nk-kotsomitis/Senseed/README.md

## Introduction

Senseed, a Smart Agriculture IoT System, is an end-to-end IoT solution designed to monitor and manage agricultural environments. This repository includes the **firmware**, **hardware**, **enclosures**, and **server setup** required to deploy the system.<br>
<br>
<br>
<div align="center">
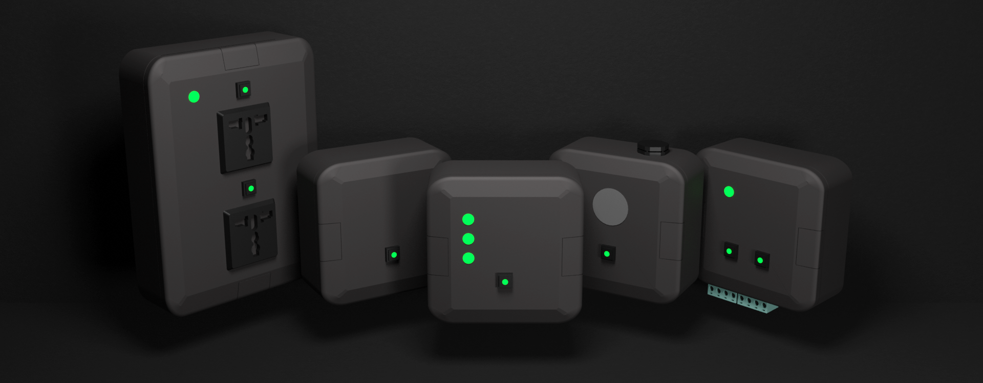
[picture p1: assets/img.png]
senseed
  
</div>
<br>
<br>

## System Overview
This system leverages a wireless sensor network in a star topology, using **NRF24L01** modules operating at 2.4GHz for communication. The network comprises soil and environmental sensors that gather data and transmit it to a central gateway. The gateway serves as the primary hub, collecting sensor data and communicating with the controllers to make real-time adjustments. <br>
<br>
For data processing and storage, the gateway connects to an Ubuntu server over **WiFi**, using the **MQTT** protocol with **RabbitMQ** as the message broker. On the server side, **InfluxDB** is used for time-series data storage. <br>

<br>
<br>
<div align="center">
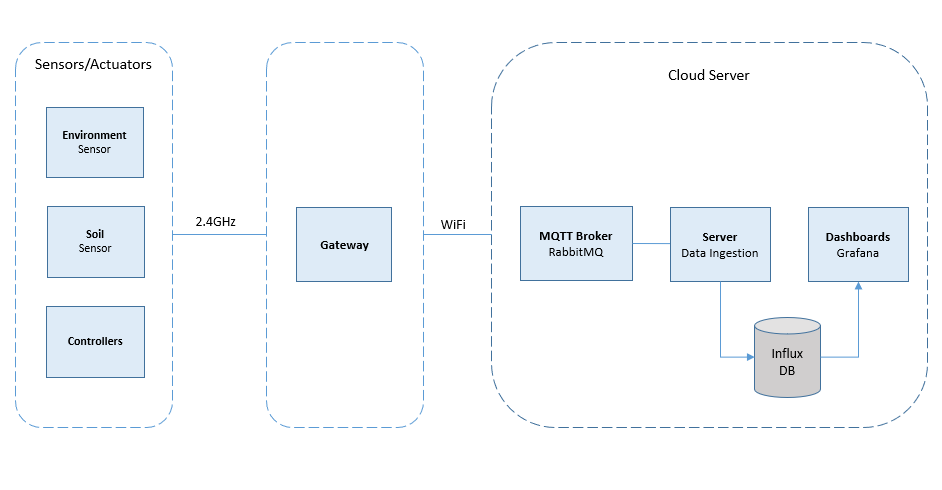
[picture p2: assets/img2.png]
overview
  
</div>
<br>
<br>

The gateway is powered by an **ATMEGA1284** and connects to the internet via an **ESP32** module, utilizing AT commands. The sensors and controllers in the system are based on the **ATMEGA328P** microcontroller. <br>
<br>
The environmental sensor is optimized for low-power operation, measuring temperature and humidity with a high-precision SHT40 sensor while also monitoring battery voltage to ensure reliable performance over extended periods. <br>
<br>
The soil sensor assesses soil moisture levels using a moisture probe. <br>
<br>
The controllers are designed for both low and high-power applications, managing devices through relay control. Each controller is equipped with a battery-powered real-time clock (RTC) to maintain accurate time in case of power outages. The high-power controller additionally monitors current consumption using an ACS712 sensor for enhanced energy management.

<br>
<br>

**IMPORTANT NOTE: This repository contains a proof-of-concept implementation and is intended for demonstration purposes to showcase architecture design and coding practices. Some components are intentionally missing or incomplete, so the system is not production-ready.**
