nk-kotsomitis/Senseed/hardware/controllers/BOM_controller_low_power_v1.0.1.xlsx

# | Reference Designators | Quantity | MPN | Manufacturer | Part Description | Value | Package | Remark or Link
1 | U1 | 1 | ATMEGA328P-AU | Microchip Technology / Atmel | 8-bit Microcontrollers - MCU 32KB In-system Flash 20MHz 1.8V-5.5V | ATMEGA328P_TQFP | TQFP-32
2 | U3 | 1 | SPX1117M3-L-3-3/TR | Maxlinear | LDO Voltage Regulators 3.3V 0.8A Positive | 3.3 V | SOT-223-3
3 | U5 | 1 | - | - | NRF24L01+ 2.4GHz Wireless RF Transceiver Module | - | Plug In Module - 2x4 2.54mm header | Customer Provided
4 | U6 | 1 | MCP79410T-I/SN | Microchip Technology | Real Time Clock I2C GP RTCC 1Kb EE 64B SRAM ID | - | SOIC-8
5 | BH1 | 1 | MY-1220-03 | MYOUNG | Coin Cell Battery Holder CR1220 SMT | - | SMD
6 | K1, K2 | 2 | G2RL-1A-E-ASI DC5 | Omron Electronics | General Purpose Relays 1 form A w/ TV3 5VDC Coil, 16A | Power Relays | Through Hole
7 | Y1 | 1 | TAXM4M2ILFBET2T | TAE(Zhejiang Abel Elec) | ±30ppm -20℃~70℃ 49SMD 20pF 80Ω 4000000Hz HC-49S/SMD Crystals | 4 MHz | HC-49/S
8 | Y2 | 1 | JFWSH32K25A104C | SHENZHEN JINGFA ELECTRONICS | Radial Cylinder Crystal 32.768KHz ±20ppm 12.5pF 30 KOhm(Max) Radial,3x8mm | 32.768 kHz | OSC-TH Radial 3x8mm
9 | J2, J3 | 2 | PH2.0-4P | CAX | 4-Pin Low-profile PH2.0 Housing Connector | 4 Position | Through Hole
10 | LED | 1 | 204-10SUGC/S400-A5-L | Everlight Elec | Green 525nm Through Hole 3mm Light Emitting Diodes (LED) - Water Clear | 3mm Green - Clear | Through Hole
11 | LED | 1 | ERM 1-955 | Bivar | LED Mounting Hardware LED Mount Self Ret Universal LED Black | T-1 3/4 (5mm) | -
12 | J5 | 1 | C65114 | BOOMELE(Boom Precision Elec) | 2 2.54mm 6 Straight Header，Breakaway P=2.54mm Pin Headers | 6 Position | Through Hole
13 | J6 | 1 | PZ254V-11-02P | XFCN | 2.54mm Straight 2 1 Header，Breakaway Through Hole,P=2.54mm Pin Headers | 2 Position | Through Hole
14 | J7, J8 | 2 | WJ2EDGRC-5.08-4P | Ningbo Kangnex Elec | Pluggable Terminal Blocks 4Pins Pitch 5.08 Right Angle | 4 Position | Through Hole
15 | Q1, Q2 | 2 | MMBT2222A |  | (BJT) NPN 600mA 40V SURFACE MOUNT TRANSISTOR | NPN | SOT23-3
16 | D1, D2 | 2 | 1N4007F (M7) |  | Silicon Rectifier Diode 1A 1000V SMA | 50 V | SMA / DO-214AC
17 | C1, C2, C14, C15 | 4 | 0805CG150J500NT |  | Multilayer Ceramic Capacitor MLCC 15pF ±5% 0805 SMD | 15pF | 0805
18 | C3, C4, C5, C16 | 4 | 0805B104M500NT |  | Multilayer Ceramic Capacitor MLCC 100nF ±5% 0805 SMD | 100nF | 0805
19 | C11 | 1 | CL21B225KOFNNNE |  | Multilayer Ceramic Capacitor MLCC 2.2uF X7R ±10% 16V 0805 SMD | 2.2uF | 0805
20 | C10 | 1 | CL21A475KAQNNNE |  | Multilayer Ceramic Capacitor MLCC 4.7uF X5R ±10% 25V 0805 SMD | 4.7uF | 0805
21 | C12 | 1 | GRM21BR61C106KE15L |  | X5R ±10% 16V 10uF 0805 Multilayer Ceramic Capacitors MLCC - SMD/SMT | 10uF | 0805
22 | C13 | 1 | VD1A331ME077000CE0 | Changzhou Huawei Electronics | 6.3mm 330uF 7.7mm 10V 2000hrs 105℃ ±20% -45℃~+105℃ SMD,6.3x7.7mm Aluminum Electrolytic Capacitors - SMD | 330uF | 6.3x7.7 SMD
23 | R1, R3, R5, R9 | 4 | RC0805FR-7W10KL |  | Chip Resistor - Surface Mount 10K ±1% 1/4W 0805 | 10K 1/4W | 0805
24 | R2, R4, R11, R12 | 4 | 0805W8J1001T5E |  | Chip Resistor - Surface Mount 1K ±5% 1/8W 0805 | 1K | 0805
25 | R6, R7, R8, R10 | 4 | 0805W8J0472T5E |  | Chip Resistor - Surface Mount 4.7K ±5% 1/8W 0805 | 4K7 | 0805
 | Off-board components
26 | - | 1 | CMC_313_GTP | Visual Communications Company (VCC) | LED Lenses Green Diffused 5mm CMC313GTP | Green | -
27 | - | 2 | TC013-N11ASKKUGXX | Well Buying | Tactile Switches TACTILE/JOG SWITCH SPST50mA 12VDC180gf | Illuminated | -
28 | - | 2 | - |  | PH2.0 PH 2.0 4pin PH-4p connector with cable 100mm wire 24AWG | PH-4p 100mm 24AWG | -
29 |  | 2 | WJ2EDGK-5.08-4P | Ningbo Kangnex Elec | Pluggable Terminal Blocks Screw Connector 4Pins Pitch 5.08 | 4 Position | -
