nk-kotsomitis/Senseed/hardware/environment_sensor/BOM_env_sensor_v1.0.1.xlsx

# | Reference Designators | Quantity | MPN | Manufacturer | Part Description | Value | Package | Remark or Link
1 | U1 | 1 | ATMEGA328P-AU | Microchip Technology / Atmel | 8-bit Microcontrollers - MCU 32KB In-system Flash 20MHz 1.8V-5.5V | - | TQFP-32
2 | U2 | 1 | - | NRF24L01+ 2.4GHz Wireless RF Transceiver Module | - | Plug In Module - 2x4 2.54mm header | Customer Provided
3 | U3 | 1 | SHT40-AD1B-R2 | Sensirion | Board Mount Humidity Sensors RH/ T Sensor | SHT40-AD1B-R2 | DFN-4
4 | U4 | 1 | USEQGSEAC82180 | KEMET | Air Quality Sensors Gas Detector Sensor Digital SMD CO2 | Carbon Dioxide (CO2) | SMD/SMT
5 | U5 | 1 | TCA9406DCTR | Texas Instruments | Translation - Voltage Levels Dual Bidirec 1MHz Vltg Lev-Trans | Translation - Voltage Levels | SM-8
6 | U6 | 1 | TPS60205DGSR | Texas Instruments | Switching Voltage Regulators Regulated 3.3-V Charge Pump | 3.3 V | MSOP-10
7 | Y1 | 1 | TAXM4M2ILFBET2T | TAE(Zhejiang Abel Elec) | ±30ppm -20℃~70℃ 49SMD 20pF 80Ω 4000000Hz HC-49S/SMD Crystals | 4 MHz | HC-49/S
8 | Q1, Q2 | 2 | SSM3J328R,LF | Toshiba | MOSFET P-Ch Sm Sig FET Id -6A -20V -8VGSS | P-channel | SOT-23F-3
9 | D1 | 1 | SBAT54CLT1G | ON Semiconductor | Schottky Diodes & Rectifiers SS DUAL COMMON CATHODE | Si | SOT-23
11 | J1 | 1 | PH2.0-4P | CAX | 4-Pin Low-profile PH2.0 Housing Connector | 4 Position | Through Hole
12 | J2 | 1 | C65114 | BOOMELE(Boom Precision Elec) | 2 2.54mm 6 Straight Header，Breakaway P=2.54mm Pin Headers | 6 Position | Through Hole
13 | J3 | 1 | PZ254V-11-02P | XFCN | 2.54mm Straight 2 1 Header，Breakaway Through Hole,P=2.54mm Pin Headers | 2 Position | Through Hole
14 | J4 | 1 | 2462 | Keystone Electronics | Cylindrical Battery Contacts, Clips, Holders & Springs 2 CELL AA PC HOLDER | AA 2 Battery | Through Hole
15 | J5 | 1 | ZW-02-20-F-D-800-079 | Samtec | Board to Board & Mezzanine Connectors .100" Flex Stack, Flexible Board Stacker, Custom Tail | 4 Position | Through Hole
16 | CBAT | 1 | VD1A331ME077000CE0 | Changzhou Huawei Electronics | 6.3mm 330uF 7.7mm 10V 2000hrs 105℃ ±20% -45℃~+105℃ SMD,6.3x7.7mm Aluminum Electrolytic Capacitors - SMD | 330uF | 6.3x7.7 SMD
18 | C1, C2 | 2 | 0805CG150J500NT |  | Multilayer Ceramic Capacitor MLCC 15pF ±5% 0805 SMD | 15pF | 0805
19 | C9 | 1 | TCC0805X7R224K500DT |  | 50V 220nF X7R ±10% 0805 Multilayer Ceramic Capacitors MLCC - SMD/SMT | 220nF | 0805
20 | C3, C4, C5, C6, C8, C14, C15, C17 | 8 | 0805B104M500NT |  | Multilayer Ceramic Capacitor MLCC 100nF ±5% 0805 SMD | 100nF | 0805
21 | C11, C12 | 2 | CL21B105KOFNNNE |  | Multilayer Ceramic Capacitor MLCC 1uF X7R ±10% 16V 0805 SMD | 1uF | 0805
22 | C10, C13 | 2 | CL21B225KOFNNNE |  | Multilayer Ceramic Capacitor MLCC 2.2uF X7R ±10% 16V 0805 SMD | 2.2uF | 0805
23 | C7 | 1 | GRM21BR61C106KE15L |  | X5R ±10% 16V 10uF 0805 Multilayer Ceramic Capacitors MLCC - SMD/SMT | 10uF | 0805
24 | C16 | 1 | CL21A475KAQNNNE |  | 25V 4.7uF X5R ±10% 0805 Multilayer Ceramic Capacitors MLCC - SMD/SMT | 4.7uF | 0805
25 | R1, R6, R7, R8, R9 | 5 | RC0805FR-7W10KL |  | Chip Resistor - Surface Mount 10K ±1% 1/4W 0805 | 10K 1/4W | 0805
26 | R2 | 1 | 0805W8J0105T5E |  | Chip Resistor - Surface Mount 1M ±5% 1/8W 0805 | 1M | 0805
27 | R3 | 1 | 0805W8J0474T5E |  | Chip Resistor - Surface Mount 470K ±5% 1/8W 0805 | 470K | 0805
28 | R4, R5 | 2 | 0805W8J1001T5E |  | Chip Resistor - Surface Mount 1K ±5% 1/8W 0805 | 1K | 0805
 | Off-board components
29 | - | 1 | TC013-N11ASKKUGXX | Well Buying | Tactile Switches TACTILE/JOG SWITCH SPST50mA 12VDC180gf | Illuminated | -
30 | - | 1 | - | - | PH2.0 PH 2.0 4pin PH-4p connector with cable 100mm wire 24AWG | PH-4p 100mm 24AWG | -
