nk-kotsomitis/Senseed/hardware/environment_sensor/BOM_spectrometer_v1.0.1.xlsx

# | Reference Designators | Quantity | MPN | Manufacturer | Part Description | Value | Package
1 | U1 | 1 | AS72651-BLGT | ams | Ambient Light Sensors AS72651-BLGT LGA20 LF T&RDP | 600 nm to 870 nm | LGA-20
2 | U2 | 1 | AS72652-BLGT | ams | Ambient Light Sensors AS72652-BLGT LGA20 LF T&RDP | - | LGA-20
3 | U3 | 1 | AS72653-BLGT | ams | Ambient Light Sensors AS72653-BLGT LGA20 LF T&RDP | - | LGA-20
4 | U4 | 1 | AT25SF041B-SSHB-B | Adesto Technologies | NOR Flash 4 Mbit, 3.0V (2.7V to 3.6V), -40C to 85C, SOIC-N 150mil (Tube), Single, Dual, Quad SPI NOR flash | 4 Mbit | SOIC-8 Narrow
5 | J2 | 1 | PZ254V-12-10P | XFCN | 2 2.54mm 10 Straight Header，Breakaway Through Hole,P=2.54mm Pin Headers ROHS | 10 Position | Through Hole
6 | R1, R2 | 2 | 0805W8J0472T5E |  | Chip Resistor - Surface Mount 4.7K ±5% 1/8W 0805 | 4K7 | 0805
7 | R3, R4, R5, R6, R7 | 5 | RC0805FR-7W10KL |  | Chip Resistor - Surface Mount 10K ±1% 1/4W 0805 | 10K | 0805
8 | C1, C3, C5 | 3 | GRM21BR61C106KE15L |  | X5R ±10% 16V 10uF 0805 Multilayer Ceramic Capacitors MLCC - SMD/SMT | 10uF | 0805
9 | C2, C4, C6 | 3 | 0805B104M500NT |  | Multilayer Ceramic Capacitor MLCC 100nF ±5% 0805 SMD | 100nF | 0805
10 | C7 | 1 | UMK212B7105KG-T |  | X7R ±10% 50V 1uF 0805 Multilayer Ceramic Capacitors MLCC - SMD/SMT | 1uF | 0805
