nk-kotsomitis/Senseed/hardware/gateway/BOM_gateway_v1.0.1.xlsx

# | Reference Designators | Quantity | MPN | Manufacturer | Part Description | Value | Package | Remark or Link
1 | U1 | 1 | ATMEGA1284-AU | Microchip Technology / Atmel | 8-bit Microcontrollers - MCU AVR 128KB FLSH 4KB EE16KB SRAM-20 MHz | - | TQFP-44
2 | U2 | 1 | SPX1117M3-L-3-3/TR | Maxlinear | LDO Voltage Regulators 3.3V 0.8A Positive | 3.3V 0.8A | SOT-223-3
3 | U4 | 1 | - | - | NRF24L01+ 2.4GHz Wireless RF Transceiver Module | - | Plug In Module - 2x4 2.54mm header | Customer Provided
4 | U5 | 1 | ESP-WROOM-02D(M1102H1600PH3Q0) | Espressif Systems | WiFi Modules (802.11) SMD Module, ESP8266EX, 16Mbits SPI flash, UART Mode, PCB antenna | - | SMD module
5 | U6 | 1 | MCP79410T-I/SN | Microchip Technology | Real Time Clock I2C GP RTCC 1Kb EE 64B SRAM ID | - | SOIC-8
6 | BH1 | 1 | MY-1220-03 | MYOUNG | Coin Cell Battery Holder CR1220 SMT | - | SMD
7 | Y1 | 1 | TXM16M0004322KBCDO00T | TAE(Zhejiang Abel Elec) | ±10ppm 16000000Hz -40℃~85℃ 18pF SMD Passive Crystal Oscillator 35Ω SMD3225-4P Crystals | 16 MHz | SMD3225-4P
8 | Y2 | 1 | JFWSH32K25A104C | SHENZHEN JINGFA ELECTRONICS | Radial Cylinder Crystal 32.768KHz ±20ppm 12.5pF 30 KOhm(Max) Radial,3x8mm | 32.768 kHz | OSC-TH Radial 3x8mm
9 | J1 | 1 | PH2.0-4P | CAX | 4-Pin Low-profile PH2.0 Housing Connector | 4 Position | Through Hole
10 | LED1, LED2, LED3 | 3 | 204-10SUGC/S400-A5-L | Everlight Elec | Green 525nm Through Hole 3mm Light Emitting Diodes (LED) - Water Clear | 3mm Green - Clear | Through Hole
11 | LED1, LED2, LED3 | 3 | ERM 1-955 | Bivar | LED Mounting Hardware LED Mount Self Ret Universal LED Black | T-1 3/4 (5mm) | - | Led Spacer
12 | J6 | 1 | C65114 | BOOMELE(Boom Precision Elec) | 2 2.54mm 6 Straight Header，Breakaway P=2.54mm Pin Headers | 6 Position | Through Hole
13 | J7 | 1 | PZ254V-11-02P | XFCN | 2.54mm Straight 2 1 Header，Breakaway Through Hole,P=2.54mm Pin Headers | 2 Position | Through Hole
14 | J8 | 1 | C49257 | BOOMELE(Boom Precision Elec) | 3 2.54mm Straight 1 Header，Breakaway Through Hole Pin Headers | 3 Position | Through Hole
15 | S2, S3 | 2 | TS-1096S-A2B2-C1D2 | Yuandi | SPST Vertical Tactile Switch 3X6X5.0mm SMT | - | SMD
16 | C15, C16 | 2 | 0805CG150J500NT |  | Multilayer Ceramic Capacitor MLCC 15pF ±5% 0805 SMD | 15pF | 0805
17 | C1, C2 | 2 | 0805CG270J500NT |  | Multilayer Ceramic Capacitor MLCC 27pF ±5% 0805 SMD | 27pF | 0805
18 | C3, C4, C5, C6, C7, C13, C14, C17 | 8 | 0805B104M500NT |  | Multilayer Ceramic Capacitor MLCC 100nF ±5% 0805 SMD | 100nF | 0805
19 | C9 | 1 | CL21B225KOFNNNE |  | Multilayer Ceramic Capacitor MLCC 2.2uF X7R ±10% 16V 0805 SMD | 2.2uF | 0805
20 | C8 | 1 | CL21A475KAQNNNE |  | Multilayer Ceramic Capacitor MLCC 4.7uF X5R ±10% 25V 0805 SMD | 4.7uF | 0805
21 | C10, C12 | 2 | GRM21BR61C106KE15L |  | X5R ±10% 16V 10uF 0805 Multilayer Ceramic Capacitors MLCC - SMD/SMT | 10uF | 0805
22 | C11 | 1 | VD1A331ME077000CE0 | Changzhou Huawei Electronics | 6.3mm 330uF 7.7mm 10V 2000hrs 105℃ ±20% -45℃~+105℃ SMD,6.3x7.7mm Aluminum Electrolytic Capacitors - SMD | 330uF | 6.3x7.7 SMD
23 | R1, R2, R11, R12, R13, R16, R17, R18 | 8 | 0805W8J1002T5E |  | Chip Resistor - Surface Mount 10K ±5% 1/8W 0805 | 10K | 0805
24 | R14 | 1 | 0805W8J1001T5E |  | Chip Resistor - Surface Mount 1K ±5% 1/8W 0805 | 1K | 0805
25 | R15 | 1 | 0805W8J2001T5E |  | Chip Resistor - Surface Mount 2K ±5% 1/8W 0805 | 2K | 0805
26 | R4, R5, R6, R7, R8, R9, R10, R19 | 8 | 0805W8J0472T5E |  | Chip Resistor - Surface Mount 4.7K ±5% 1/8W 0805 | 4K7 | 0805
 | Off-board components
27 | - | 1 | TC013-N11ASKKUGXX | Well Buying | Tactile Switches TACTILE/JOG SWITCH SPST50mA 12VDC180gf | Illuminated | -
28 | - | 3 | CMC_313_GTP | Visual Communications Company (VCC) | LED Lenses Green Diffused 5mm CMC313GTP | Green | -
29 | - | 1 | - | - | PH2.0 PH 2.0 4pin PH-4p connector with cable 100mm wire 24AWG | PH-4p 100mm 24AWG | -
