nk-kotsomitis/Senseed/hardware/soil_sensor/BOM_sensor_v1.0.1.xlsx

# | Reference Designators | Quantity | MPN | Manufacturer | Part Description | Value | Package | Remark or Link
1 | U1 | 1 | ATMEGA328P-AU | Microchip Technology / Atmel | 8-bit Microcontrollers - MCU 32KB In-system Flash 20MHz 1.8V-5.5V | ATMEGA328P_TQFP | TQFP-32
2 | U2 | 1 | - | - | NRF24L01+ 2.4GHz Wireless RF Transceiver Module | - | Plug In Module - 2x4 2.54mm header | Customer Provided
3 | Y1 | 1 | TAXM4M2ILFBET2T | TAE(Zhejiang Abel Elec) | ±30ppm -20℃~70℃ 49SMD 20pF 80Ω 4000000Hz HC-49S/SMD Crystals | 4 MHz | HC-49/S
4 | Q1 | 1 | SSM3J328R,LF | Toshiba | MOSFET P-Ch Sm Sig FET Id -6A -20V -8VGSS |  | SOT-23F-3
5 | D1 | 1 | SBAT54CLT1G | ON Semiconductor | Schottky Diodes & Rectifiers SS DUAL COMMON CATHODE | Schottky Diodes | SOT-23
6 | D2, D3, D4, D5 | 4 | 1SS384TE85LF | 1SS384TE85LF | Schottky Diodes & Rectifiers 0.1A 10V Schottky Small Sig Diode | Schottky Diodes | SOT-343-4
7 | J1 | 1 | PH2.0-4P | CAX | 4-Pin Low-profile PH2.0 Housing Connector | 4 Position | Through Hole
8 | J2 | 1 | C65114 | BOOMELE(Boom Precision Elec) | 2 2.54mm 6 Straight Header，Breakaway P=2.54mm Pin Headers | 6 Position | Through Hole
9 | J3 | 1 | PZ254V-11-02P | XFCN | 2.54mm Straight 2 1 Header，Breakaway Through Hole,P=2.54mm Pin Headers | 2 Position | Through Hole
10 | J4 | 1 | 2462 | Keystone Electronics | Cylindrical Battery Contacts, Clips, Holders & Springs 2 CELL AA PC HOLDER | AA 2 Battery | Through Hole
11 | J5, J6, J7, J8 | 4 | STX-3120-3B | Kycon | Phone Connectors 3.5mm PCB STEREO BLK 3P ALL PLASTIC | 3.5 mm, 1/8 in | Through Hole
12 | CBAT | 1 | VD1A331ME077000CE0 | Changzhou Huawei Electronics | 6.3mm 330uF 7.7mm 10V 2000hrs 105℃ ±20% -45℃~+105℃ SMD,6.3x7.7mm Aluminum Electrolytic Capacitors - SMD | 330uF | 6.3x7.7 SMD
13 | C1, C2 | 2 | 0805CG150J500NT |  | Multilayer Ceramic Capacitor MLCC 15pF ±5% 0805 SMD | 15pF | 0805
14 | C3, C4, C5, C6 | 4 | 0805B104M500NT |  | Multilayer Ceramic Capacitor MLCC 100nF ±5% 0805 SMD | 100nF | 0805
15 | C8, C9, C10, C11 | 4 | UMK212B7105KG-T |  | X7R ±10% 50V 1uF 0805 Multilayer Ceramic Capacitors MLCC - SMD/SMT | 1uF | 0805
16 | C7 | 1 | GRM21BR61C106KE15L |  | X5R ±10% 16V 10uF 0805 Multilayer Ceramic Capacitors MLCC - SMD/SMT | 10uF | 0805
17 | R1, R6 | 2 | RC0805FR-7W10KL |  | Chip Resistor - Surface Mount 10K ±1% 1/4W 0805 | 10K 1/4W | 0805
18 | R2 | 1 | 0805W8J0105T5E |  | Chip Resistor - Surface Mount 1M ±5% 1/8W 0805 | 1M | 0805
19 | R3 | 1 | 0805W8J0474T5E |  | Chip Resistor - Surface Mount 470K ±5% 1/8W 0805 | 470K | 0805
20 | R4, R5, R7, R9, R11, R13 | 6 | 0805W8J1001T5E |  | Chip Resistor - Surface Mount 1K ±5% 1/8W 0805 | 1K | 0805
21 | R8, R10, R12, R14 | 4 | 0805W8J0564T5E |  | Chip Resistor - Surface Mount 560K ±5% 1/8W 0805 | 560K | 0805
 | Off-board components
22 | - | 4 | 172-1283 | Kobiconn | Audio Cables / Video Cables / RCA Cables 3.5 MONO PL-S/T 36" | 3.5 mm Mono Plug | -
23 | - | 1 | TC013-N11ASKKUGXX | Well Buying | Tactile Switches TACTILE/JOG SWITCH SPST50mA 12VDC180gf | Illuminated | -
24 | - | 1 | - | - | PH2.0 PH 2.0 4pin PH-4p connector with cable 100mm wire 24AWG | PH-4p 100mm 24AWG | -
