nk-kotsomitis/Senseed/(list of files, cad)

Other CAD files:
mechanical/controllers/WP13-18-5 G_controller.dwg
mechanical/environment_sensor/PMF-12HAB_environment_sensor.dwg
mechanical/gateway/WP10-10-4 G_gateway.dwg
mechanical/soil_sensor/WP10-10-4G_soil_sensor.dwg
mechanical/environment_sensor/WP10-10-4G_environment_sensor.dwg
