nk-kotsomitis/Senseed/hardware/controllers/Controller_high_power_v1.0.brd

## EAGLE design hardware/controllers/Controller_high_power_v1.0.brd (2025-03-04)

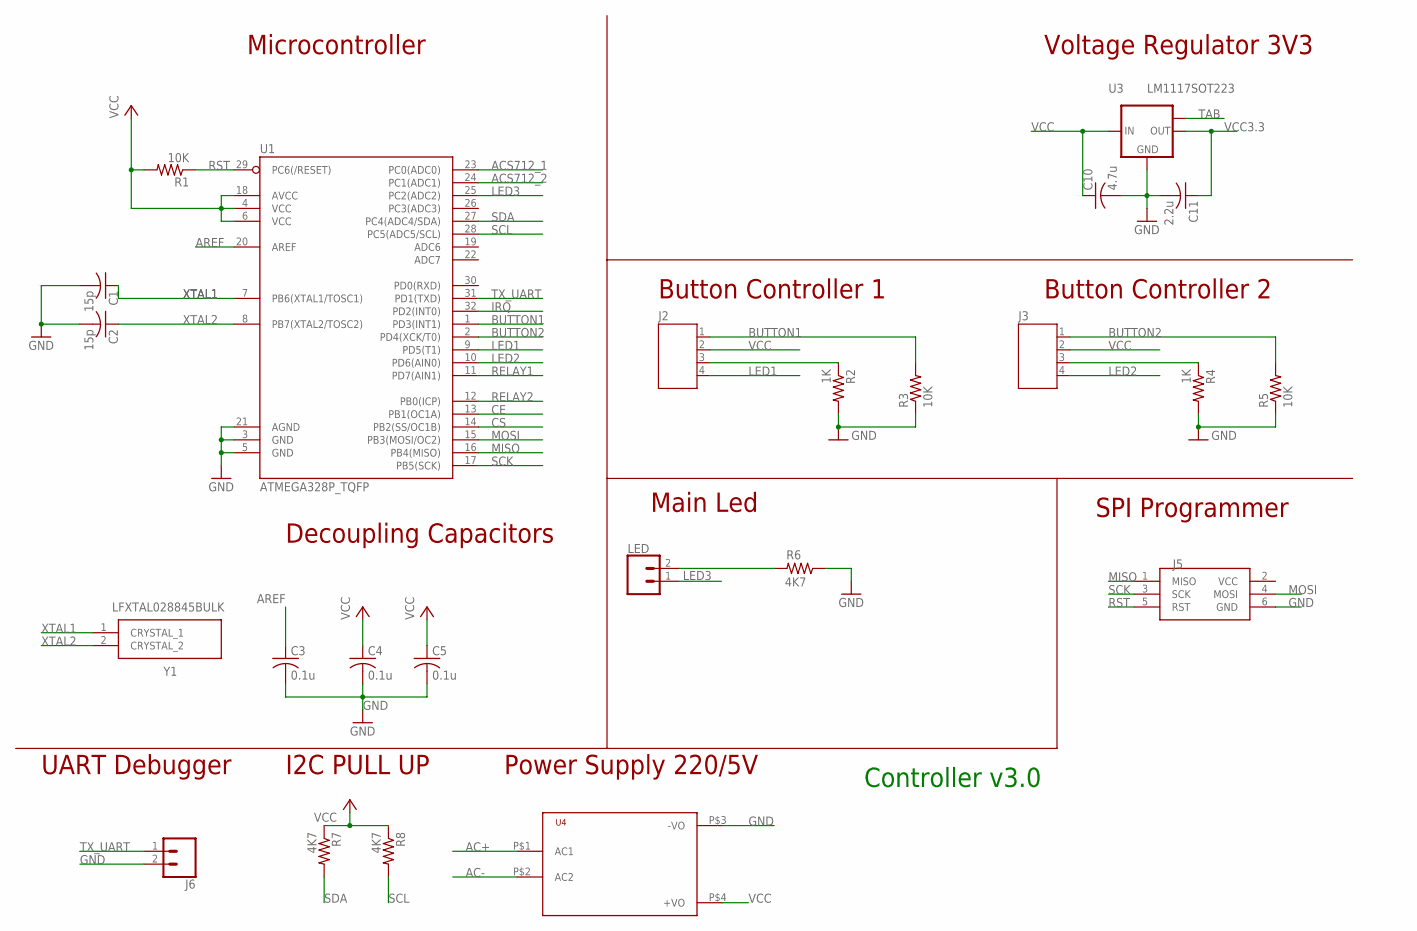
[picture p4: schematic Controller_high_power_v1.0.sch, sheet 1]

Parts:
C1, C2: 15p; SMD-0805
C3, C4, C5: 0.1u; SMD-0805
C10: 4.7u; SMD-0805
C11: 2.2u; SMD-0805
J2, J3: JST-PH4
J5: ISP; AVRISP
J6: CONN_02; 1X02
LED: CONN_02; 1X02
R1, R3, R5: 10K; SMD-0805
R2, R4: 1K; SMD-0805
R6, R7, R8: 4K7; SMD-0805
U1: ATMEGA328P_TQFP; TQFP32-08
U3: LM1117SOT223; SOT223
U4: HKLPM01
Y1: LFXTAL028845BULK

Connections:
AC+: U4.P$1 (AC1); also elsewhere on the board
AC-: U4.P$2 (AC2); also elsewhere on the board
ACS712_1: U1.23 (PC0(ADC0)); also elsewhere on the board
ACS712_2: U1.24 (PC1(ADC1)); also elsewhere on the board
AREF: C3.1, U1.20 (AREF)
BUTTON1: J2.1, R3.2, U1.1 (PD3(INT1))
BUTTON2: J3.1, R5.2, U1.2 (PD4(XCK/T0))
CE: U1.13 (PB1(OC1A)); also elsewhere on the board
CS: U1.14 (PB2(SS/OC1B)); also elsewhere on the board
GND: C1.2, C2.2, C3.2, C4.2, C5.2, C10.2, C11.2, J5.6 (GND), J6.2, R2.2, R3.1, R4.2, R5.1, R6.1, U1.3 (GND), U1.5 (GND), U1.21 (AGND), U3.1 (GND), U4.P$3 (-VO); also elsewhere on the board
IRQ: U1.32 (PD2(INT0)); also elsewhere on the board
LED1: J2.4, U1.9 (PD5(T1))
LED2: J3.4, U1.10 (PD6(AIN0))
LED3: LED.1, U1.25 (PC2(ADC2))
MISO: J5.1 (MISO), U1.16 (PB4(MISO)); also elsewhere on the board
MOSI: J5.4 (MOSI), U1.15 (PB3(MOSI/OC2)); also elsewhere on the board
unnamed: LED.2, R6.2
unnamed: J2.3, R2.1
unnamed: J3.3, R4.1
RELAY1: U1.11 (PD7(AIN1)); also elsewhere on the board
RELAY2: U1.12 (PB0(ICP)); also elsewhere on the board
RST: J5.5 (RST), R1.1, U1.29 (PC6(/RESET))
SCK: J5.3 (SCK), U1.17 (PB5(SCK)); also elsewhere on the board
SCL: R8.2, U1.28 (PC5(ADC5/SCL)); also elsewhere on the board
SDA: R7.2, U1.27 (PC4(ADC4/SDA)); also elsewhere on the board
TAB: U3.TAB (OUT1)
TX_UART: J6.1, U1.31 (PD1(TXD))
VCC: C4.1, C5.1, C10.1, J2.2, J3.2, J5.2 (VCC), R1.2, R7.1, R8.1, U1.4 (VCC), U1.6 (VCC), U1.18 (AVCC), U3.3 (IN), U4.P$4 (+VO); also elsewhere on the board
VCC3.3: C11.1, U3.2 (OUT); also elsewhere on the board
XTAL1: C1.1, U1.7 (PB6(XTAL1/TOSC1)), Y1.1 (CRYSTAL_1)
XTAL2: C2.1, U1.8 (PB7(XTAL2/TOSC2)), Y1.2 (CRYSTAL_2)

Notes on the sheet:
Controller v3.0
Decoupling Capacitors
Voltage Regulator 3V3
Microcontroller
UART Debugger
SPI Programmer
I2C PULL UP
Main Led
Button Controller 1
Power Supply 220/5V
Button Controller 2

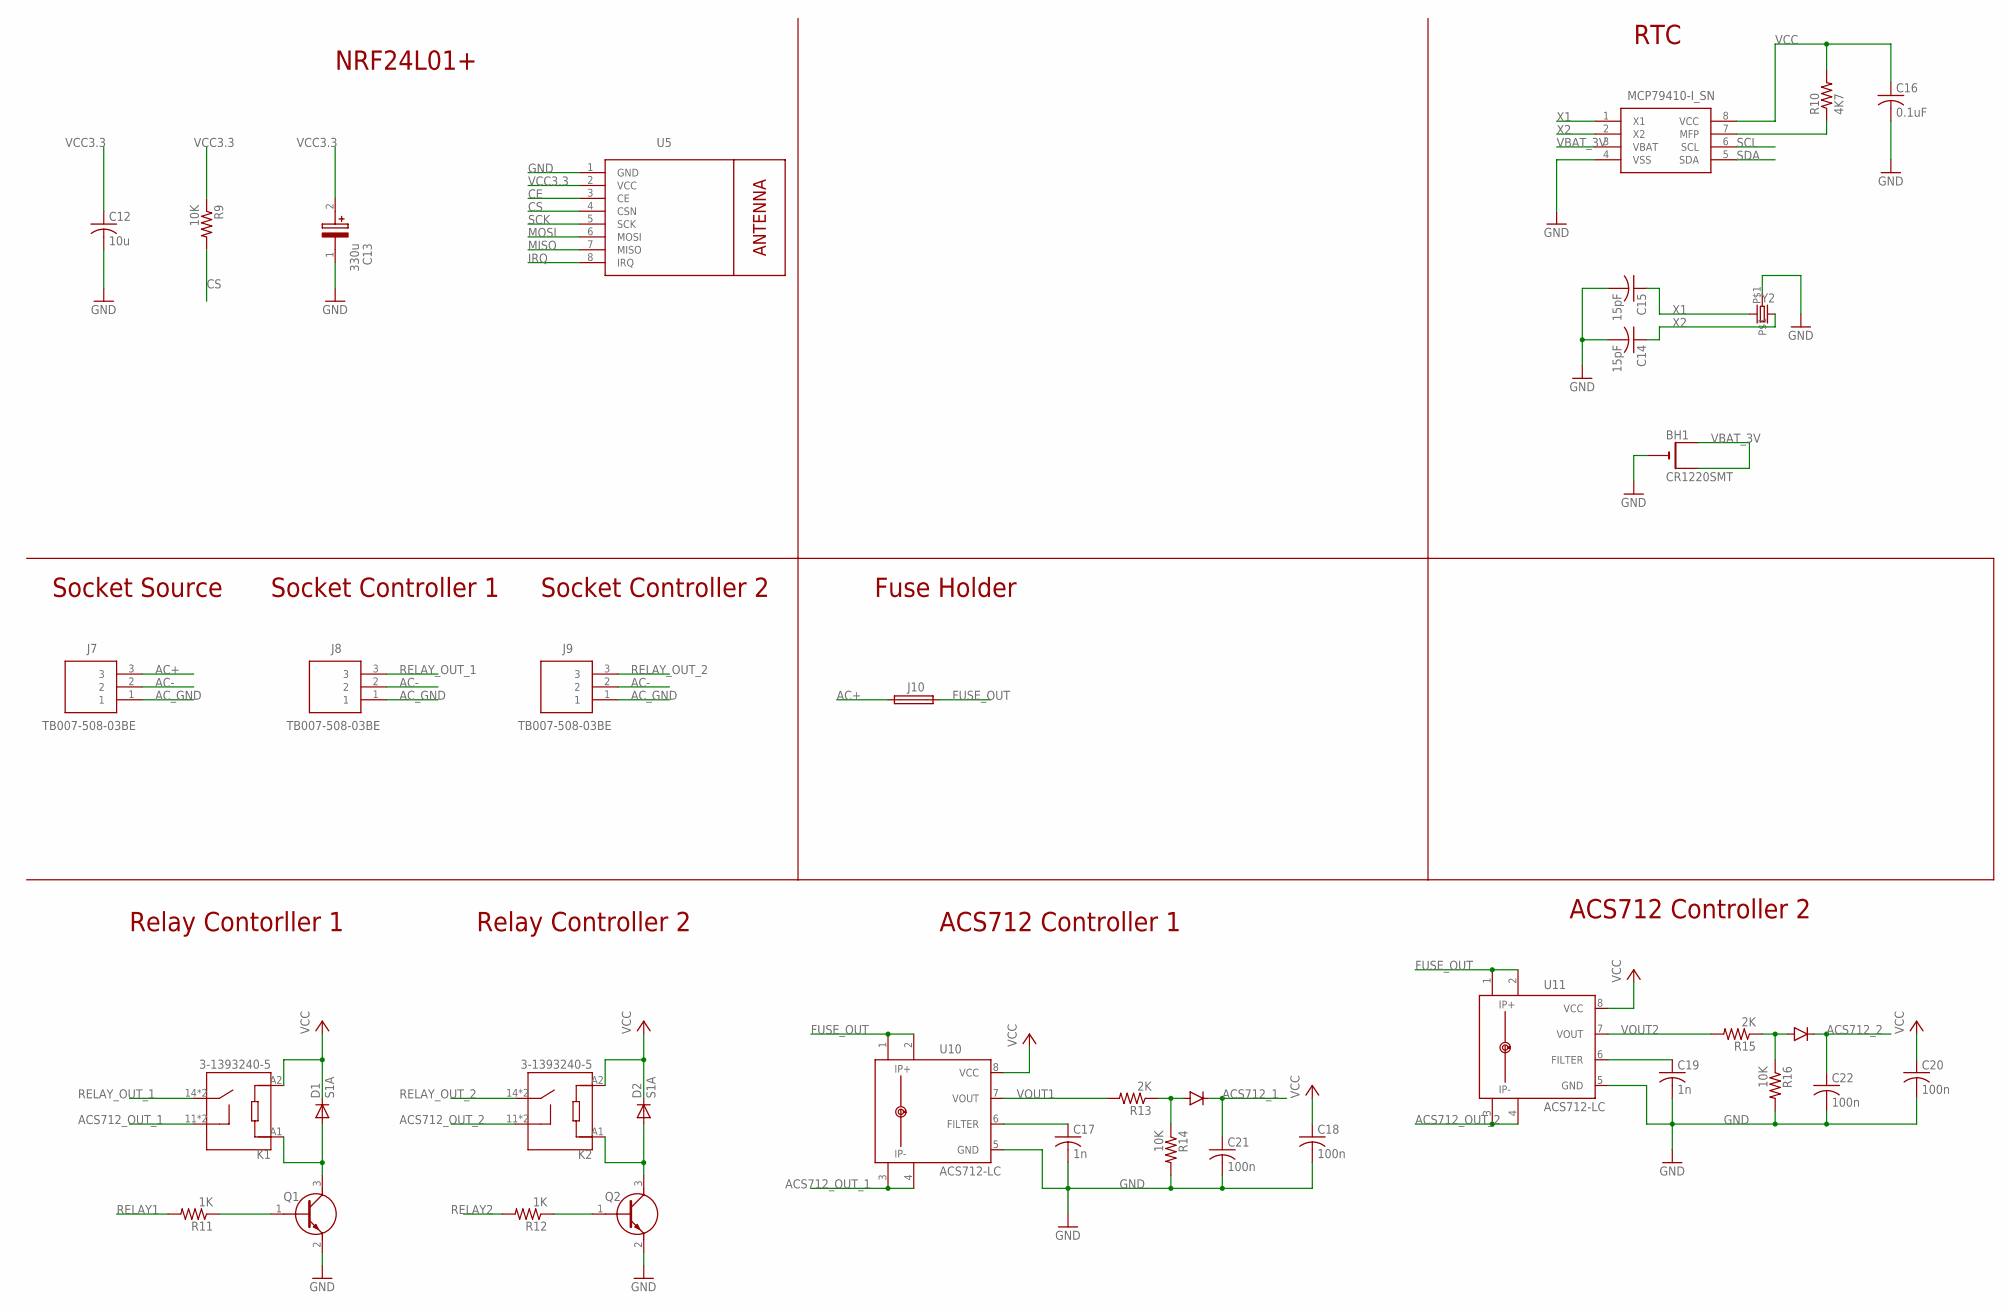
[picture p5: schematic Controller_high_power_v1.0.sch, sheet 2]

Parts:
BH1: CR1220SMT; CR1220-SMD
C12: 10u; SMD-0805
C13: 330u; SMD_LYTIC_D8
C14, C15: 15pF; SMD-0805
C16: 0.1uF; SMD-0805
C17, C19: 1n; SMD-0805
C18, C20, C21, C22: 100n; SMD-0805
D1, D2: S1A; DO214AC
D3, D4: DIODE; SOD-323
J7, J8, J9: TB007-508-03BE; TB00750803BE
J10: SH22,5A
K1, K2: 3-1393240-5; TE_3-1393240-5
Q1, Q2: MMBT2222A-TP; SI2305TP
R9, R14, R16: 10K; SMD-0805
R10: 4K7; SMD-0805
R11, R12: 1K; SMD-0805
R13, R15: 2K; SMD-0805
U5: WIRELESS-NRF24L01
U6: MCP79410-I_SN; SOIC127P600X175-8N
U10, U11: ACS712-LC; SOIC8
Y2: CRYSTALTC26H; TC26H

Connections:
AC+: J7.3, J10.1; also elsewhere on the board
AC-: J7.2, J8.2, J9.2; also elsewhere on the board
ACS712_1: C21.1, D3.C; also elsewhere on the board
ACS712_2: C22.1, D4.C; also elsewhere on the board
ACS712_OUT_1: K1.11, K1.11-1 (11), U10.3 (IP-), U10.4 (IP-1)
ACS712_OUT_2: K2.11, K2.11-1 (11), U11.3 (IP-), U11.4 (IP-1)
AC_GND: J7.1, J8.1, J9.1
CE: U5.3 (CE); also elsewhere on the board
CS: R9.2, U5.4 (CSN); also elsewhere on the board
FUSE_OUT: J10.2, U10.1 (IP+), U10.2 (IP+1), U11.1 (IP+), U11.2 (IP+1)
GND: BH1.-, C12.2, C13.1, C14.2, C15.2, C16.2, C17.2, C18.2, C19.2, C20.2, C21.2, C22.2, Q1.2 (E), Q2.2 (E), R14.2, R16.2, U5.1 (GND), U6.4 (VSS), U10.5 (GND), U11.5 (GND), Y2.P$1; also elsewhere on the board
IRQ: U5.8 (IRQ); also elsewhere on the board
MISO: U5.7 (MISO); also elsewhere on the board
MOSI: U5.6 (MOSI); also elsewhere on the board
unnamed: Q2.1 (B), R12.1
unnamed: D2.A, K2.A1, Q2.3 (C)
unnamed: D1.A, K1.A1, Q1.3 (C)
unnamed: C19.1, U11.6 (FILTER)
unnamed: C17.1, U10.6 (FILTER)
unnamed: Q1.1 (B), R11.1
unnamed: D4.A, R15.1, R16.1
unnamed: D3.A, R13.1, R14.1
unnamed: R10.1, U6.7 (MFP)
RELAY1: R11.2; also elsewhere on the board
RELAY2: R12.2; also elsewhere on the board
RELAY_OUT_1: J8.3, K1.14, K1.14-1 (14)
RELAY_OUT_2: J9.3, K2.14, K2.14-1 (14)
SCK: U5.5 (SCK); also elsewhere on the board
SCL: U6.6 (SCL); also elsewhere on the board
SDA: U6.5 (SDA); also elsewhere on the board
VBAT_3V: BH1.+$1 (+), BH1.+$2 (+1), U6.3 (VBAT)
VCC: C16.1, C18.1, C20.1, D1.C, D2.C, K1.A2, K2.A2, R10.2, U6.8 (VCC), U10.8 (VCC), U11.8 (VCC); also elsewhere on the board
VCC3.3: C12.1, C13.2, R9.1, U5.2 (VCC); also elsewhere on the board
VOUT1: R13.2, U10.7 (VOUT)
VOUT2: R15.2, U11.7 (VOUT)
X1: C15.1, U6.1 (X1), Y2.2
X2: C14.1, U6.2 (X2), Y2.1

Notes on the sheet:
NRF24L01+
Relay Contorller 1
ACS712 Controller 1
Socket Source
Fuse Holder
RTC
Relay Controller 2
Socket Controller 1
Socket Controller 2
ACS712 Controller 2

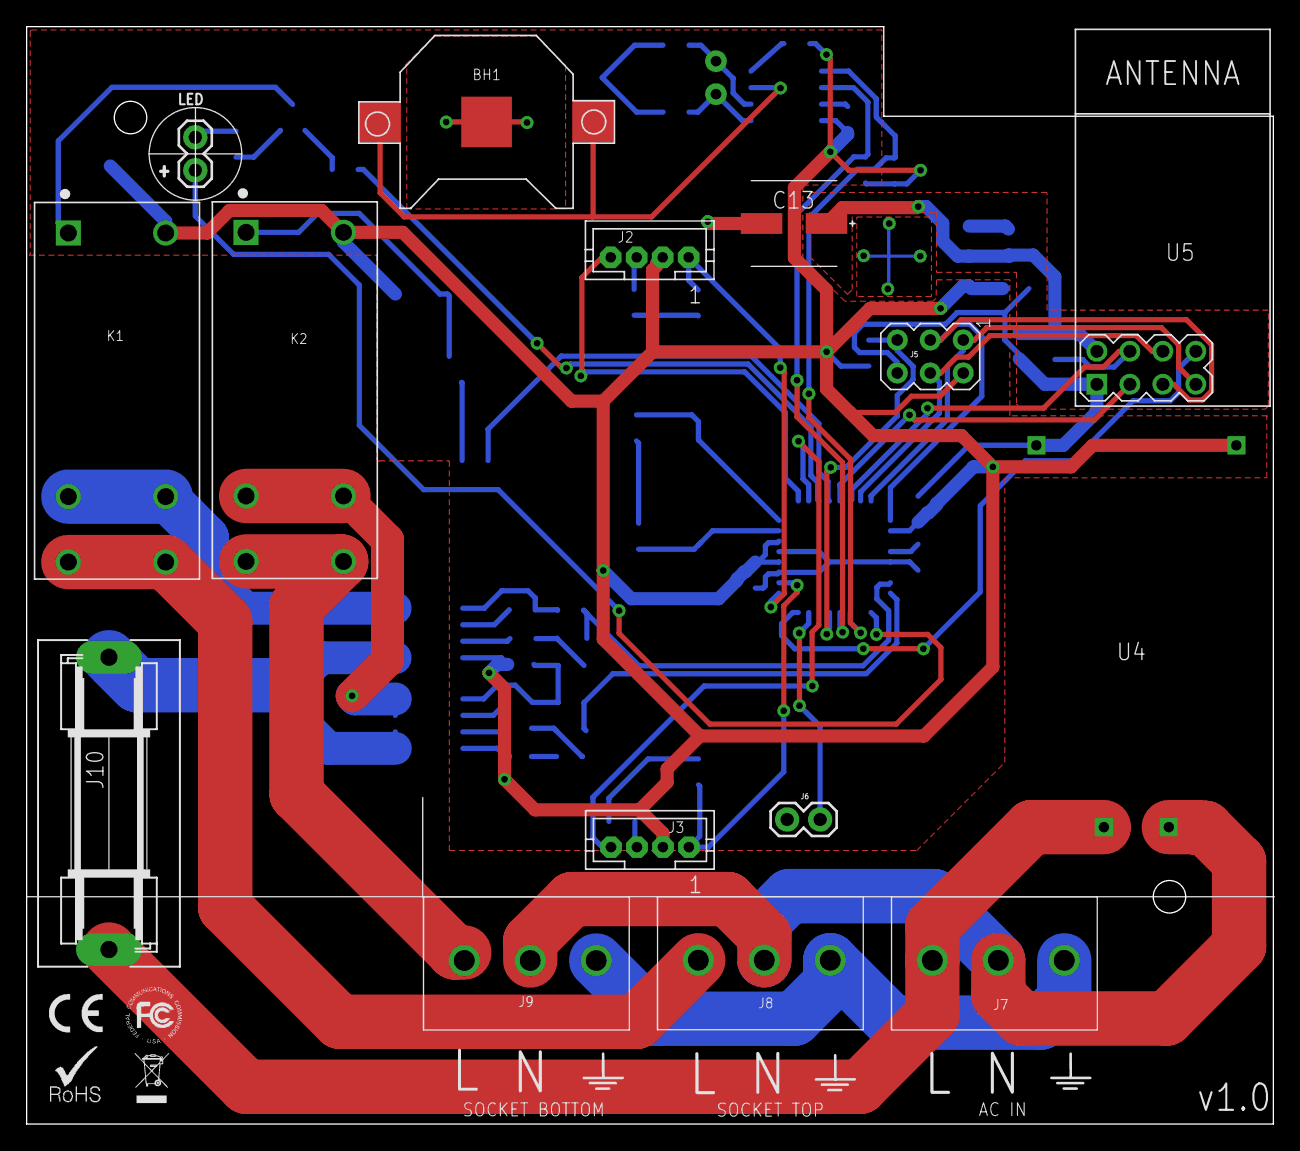
[picture p6: board Controller_high_power_v1.0.brd from above]

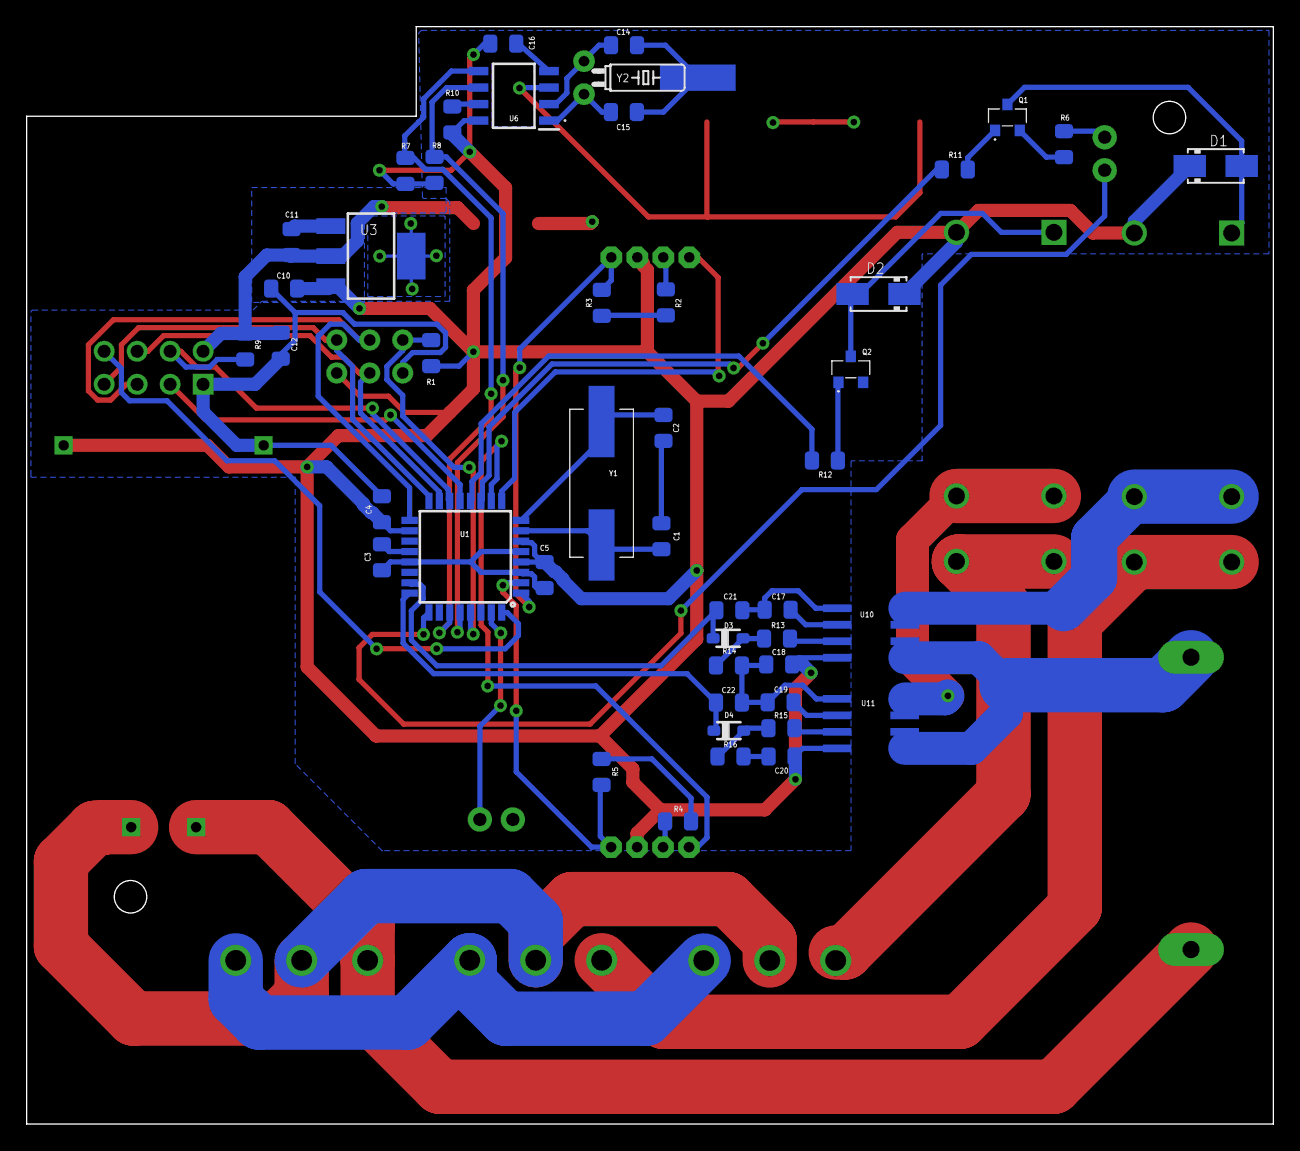
[picture p7: board Controller_high_power_v1.0.brd from below]

Board: 2 copper layers, 96.0 x 84.5 mm, 61 parts (46 on the bottom side), 50 nets.
