nk-kotsomitis/Senseed/hardware/environment_sensor/Spectrometer_v1.0.brd

## EAGLE design hardware/environment_sensor/Spectrometer_v1.0.brd (2025-03-04)

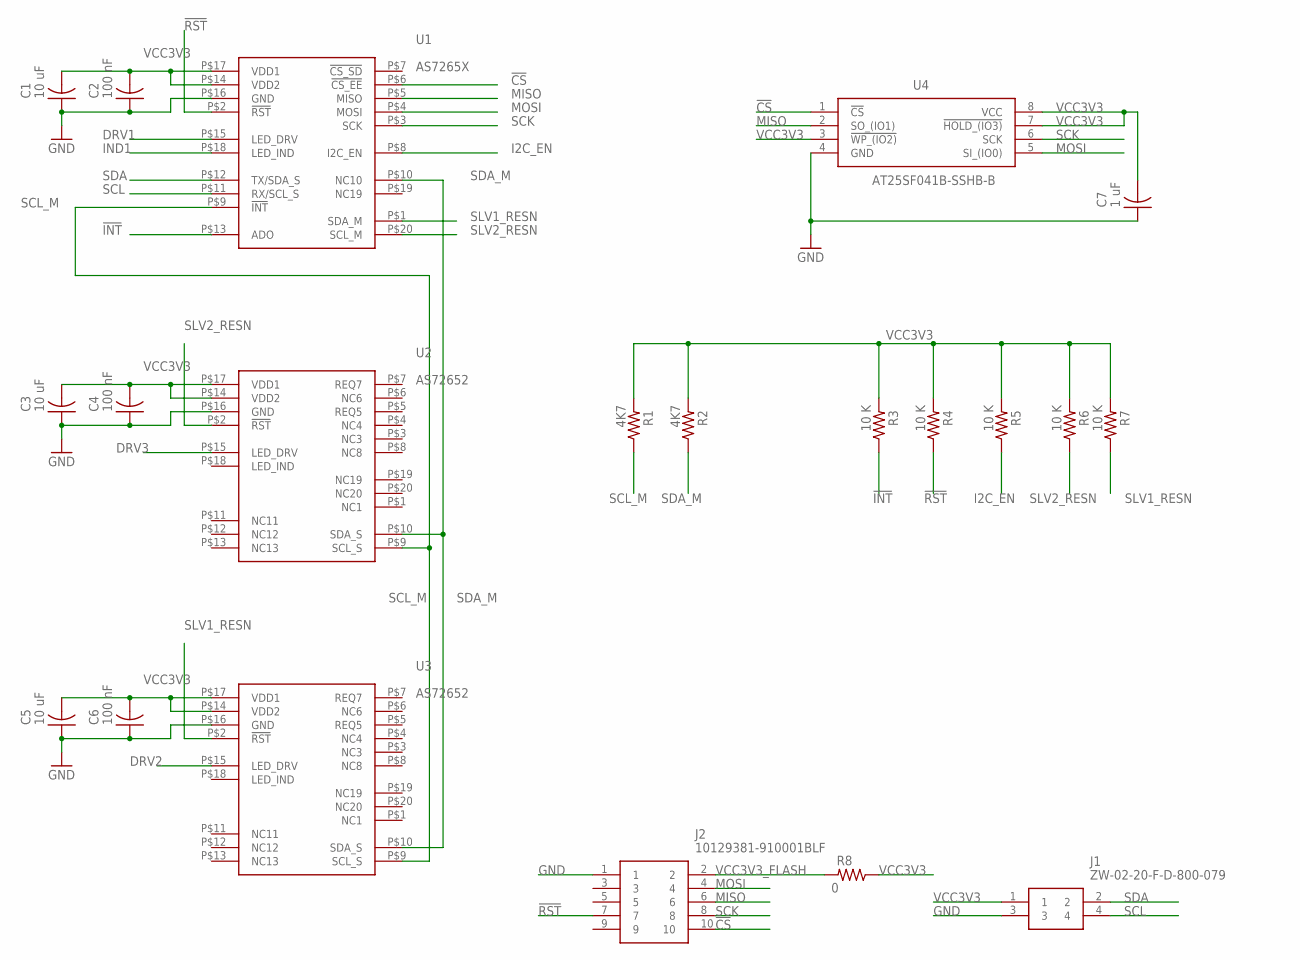
[picture p8: schematic Spectrometer_v1.0.sch]

Parts:
C1, C3, C5: 10 uF; SMD-0805
C2, C4, C6: 100 nF; SMD-0805
C7: 1 uF; SMD-0805
J1: ZW-02-20-F-D-800-079; HDRV4W64P254_2X2_508X508X2669P
J2: 10129381-910001BLF; HDRV10W67P254_2X5_1270X483X858
R1, R2: 4K7; SMD-0805
R3, R4, R5, R6, R7: 10 K; SMD-0805
R8: 0; SMD-0805
U1: AS7265X
U2, U3: AS72652; AS7265X
U4: AT25SF041B-SSHB-B; SOIC127P600X175-8N

Connections:
!CS: J2.10, U1.P$6 (!CS_EE), U4.1 (!CS)
!INT: R3.1, U1.P$13 (ADO)
!RST: J2.7, R4.1, U1.P$2 (!RST)
DRV1: U1.P$15 (LED_DRV)
DRV2: U3.P$15 (LED_DRV)
DRV3: U2.P$15 (LED_DRV)
GND: C1.1, C2.1, C3.1, C4.1, C5.1, C6.1, C7.1, J1.3, J2.1, U1.P$16 (GND), U2.P$16 (GND), U3.P$16 (GND), U4.4 (GND)
I2C_EN: R5.1, U1.P$8 (I2C_EN)
IND1: U1.P$18 (LED_IND)
MISO: J2.6, U1.P$5 (MISO), U4.2 (SO_(IO1))
MOSI: J2.4, U1.P$4 (MOSI), U4.5 (SI_(IO0))
SCK: J2.8, U1.P$3 (SCK), U4.6 (SCK)
SCL: J1.4, U1.P$11 (RX/SCL_S)
SCL_M: R1.1, U1.P$9 (!INT), U2.P$9 (SCL_S), U3.P$9 (SCL_S)
SDA: J1.2, U1.P$12 (TX/SDA_S)
SDA_M: R2.1, U1.P$10 (NC10), U2.P$10 (SDA_S), U3.P$10 (SDA_S)
SLV1_RESN: R7.1, U1.P$1 (SDA_M), U3.P$2 (!RST)
SLV2_RESN: R6.1, U1.P$20 (SCL_M), U2.P$2 (!RST)
VCC3V3: C1.2, C2.2, C3.2, C4.2, C5.2, C6.2, C7.2, J1.1, R1.2, R2.2, R3.2, R4.2, R5.2, R6.2, R7.2, R8.1, U1.P$14 (VDD2), U1.P$17 (VDD1), U2.P$14 (VDD2), U2.P$17 (VDD1), U3.P$14 (VDD2), U3.P$17 (VDD1), U4.3 (!WP_(IO2)), U4.7 (!HOLD_(IO3)), U4.8 (VCC)
VCC3V3_FLASH: J2.2, R8.2

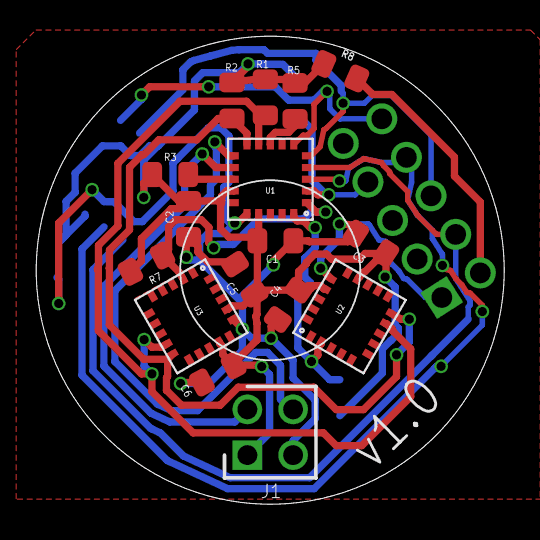
[picture p9: board Spectrometer_v1.0.brd from above]

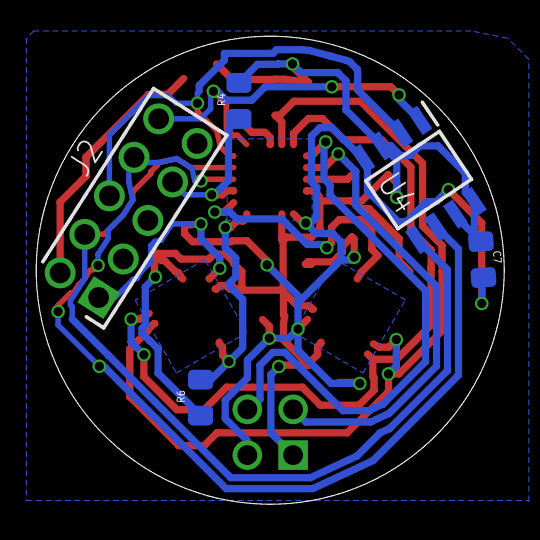
[picture p10: board Spectrometer_v1.0.brd from below]

Board: 2 copper layers, 26.0 x 26.0 mm, 21 parts (5 on the bottom side), 16 nets.
