nk-kotsomitis/Senseed/hardware/gateway/Gateway_v1.0.brd

## EAGLE design hardware/gateway/Gateway_v1.0.brd (2025-03-04)

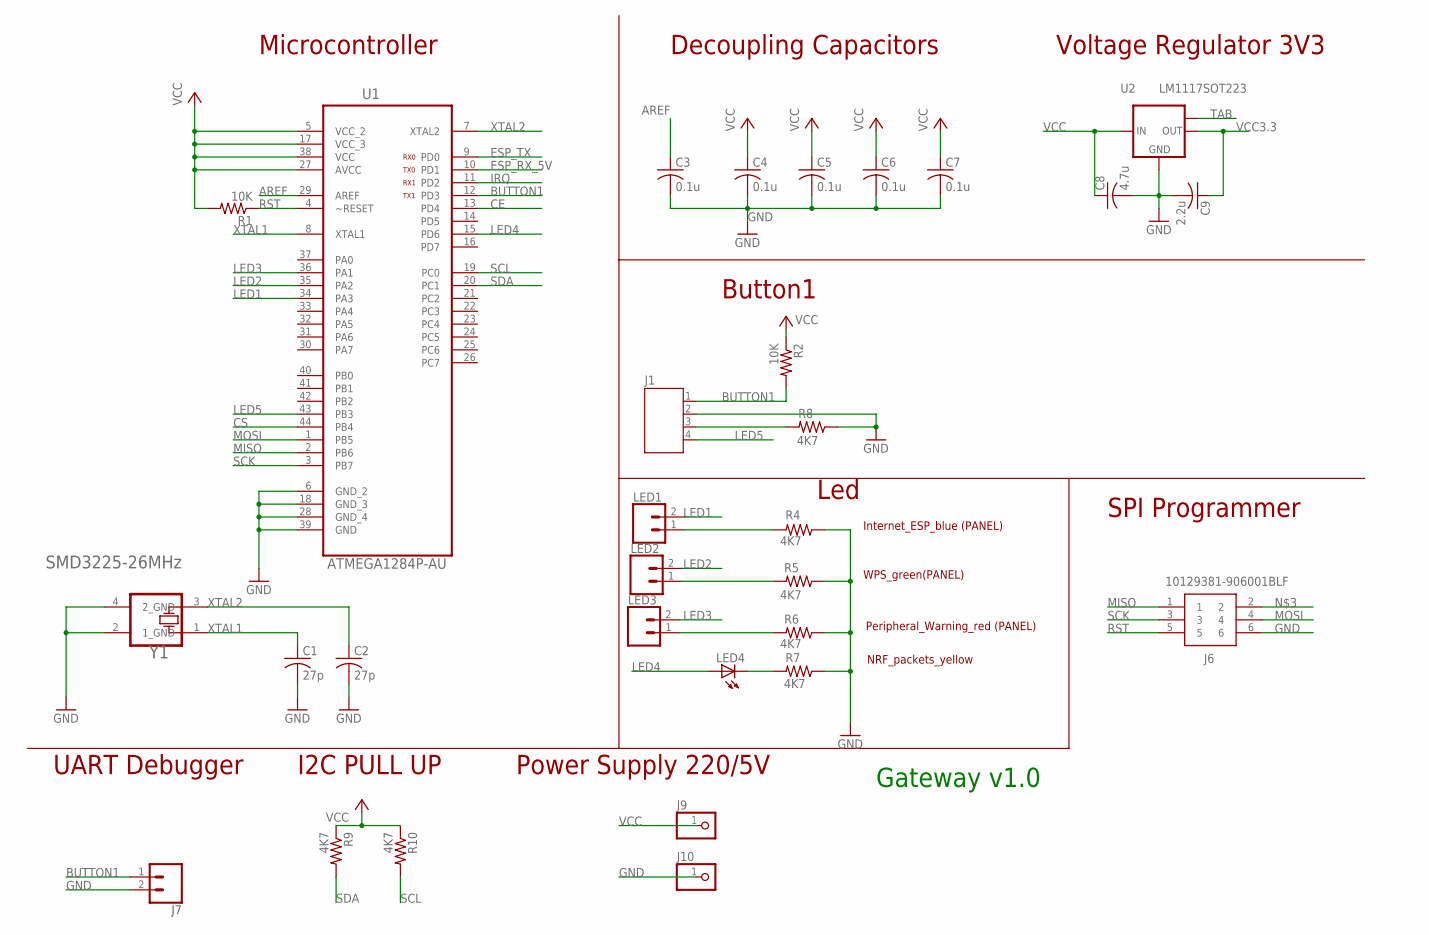
[picture p11: schematic Gateway_v1.0.sch, sheet 1]

Parts:
C1, C2: 27p; SMD-0805
C3, C4, C5, C6, C7: 0.1u; SMD-0805
C8: 4.7u; SMD-0805
C9: 2.2u; SMD-0805
J1: JST-PH4
J6: 10129381-906001BLF; HDRV6W67P254_2X3_762X483X858P
J7: CONN_02; 1X02
J9, J10: PINHD-1X1CB; 1X01-CLEANBIG
LED1, LED2, LED3: CONN_02; 1X02
LED4: LED4; SMD-0805-LED
R1, R2: 10K; SMD-0805
R4, R5, R6, R7, R8, R9, R10: 4K7; SMD-0805
U1: ATMEGA1284P-AU; QFP80P1200X1200X120-44N
U2: LM1117SOT223; SOT223
Y1: TND_ELECTRONIC_SMD3225-26MHZTND_ELECTRONIC_SMD322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; TND_ELECTRONIC_SMD3225-26MHZ_0

Connections:
AREF: C3.1, U1.29 (AREF)
BUTTON1: J1.1, J7.1, R2.2, U1.12 (PD3)
CE: U1.13 (PD4); also elsewhere on the board
CS: U1.44 (PB4); also elsewhere on the board
ESP_RX_5V: U1.10 (PD1); also elsewhere on the board
ESP_TX: U1.9 (PD0); also elsewhere on the board
GND: C1.2, C2.2, C3.2, C4.2, C5.2, C6.2, C7.2, C8.2, C9.2, J1.2, J6.6, J7.2, J10.1, R4.1, R5.1, R6.1, R7.1, R8.1, U1.6 (GND_2), U1.18 (GND_3), U1.28 (GND_4), U1.39 (GND), U2.1 (GND), Y1.2 (1_GND), Y1.4 (2_GND); also elsewhere on the board
IRQ: U1.11 (PD2); also elsewhere on the board
LED1: LED1.2, U1.34 (PA3)
LED2: LED2.2, U1.35 (PA2)
LED3: LED3.2, U1.36 (PA1)
LED4: LED4.1 (A), U1.15 (PD6)
LED5: J1.4, U1.43 (PB3)
MISO: J6.1, U1.2 (PB6); also elsewhere on the board
MOSI: J6.4, U1.1 (PB5); also elsewhere on the board
unnamed: LED2.1, R5.2
unnamed: LED3.1, R6.2
unnamed: LED1.1, R4.2
unnamed: J1.3, R8.2
unnamed: LED4.2 (C), R7.2
RST: J6.5, R1.1, U1.4 (~RESET)
SCK: J6.3, U1.3 (PB7); also elsewhere on the board
SCL: R10.2, U1.19 (PC0); also elsewhere on the board
SDA: R9.2, U1.20 (PC1); also elsewhere on the board
VCC: C4.1, C5.1, C6.1, C7.1, C8.1, J9.1, R1.2, R2.1, R9.1, R10.1, U1.5 (VCC_2), U1.17 (VCC_3), U1.27 (AVCC), U1.38 (VCC), U2.3 (IN); also elsewhere on the board
VCC3.3: C9.1, U2.2 (OUT); also elsewhere on the board
XTAL1: C1.1, U1.8 (XTAL1), Y1.1 (X1)
XTAL2: C2.1, U1.7 (XTAL2), Y1.3 (X2)
ΤΑΒ: U2.TAB (OUT1)

Notes on the sheet:
Gateway v1.0
Decoupling Capacitors
Voltage Regulator 3V3
Microcontroller
UART Debugger
SPI Programmer
I2C PULL UP
Led
Button1
TX1
RX1
Power Supply 220/5V
Internet_ESP_blue (PANEL)
NRF_packets_yellow
Peripheral_Warning_red (PANEL)
WPS_green(PANEL)
TX0
RX0

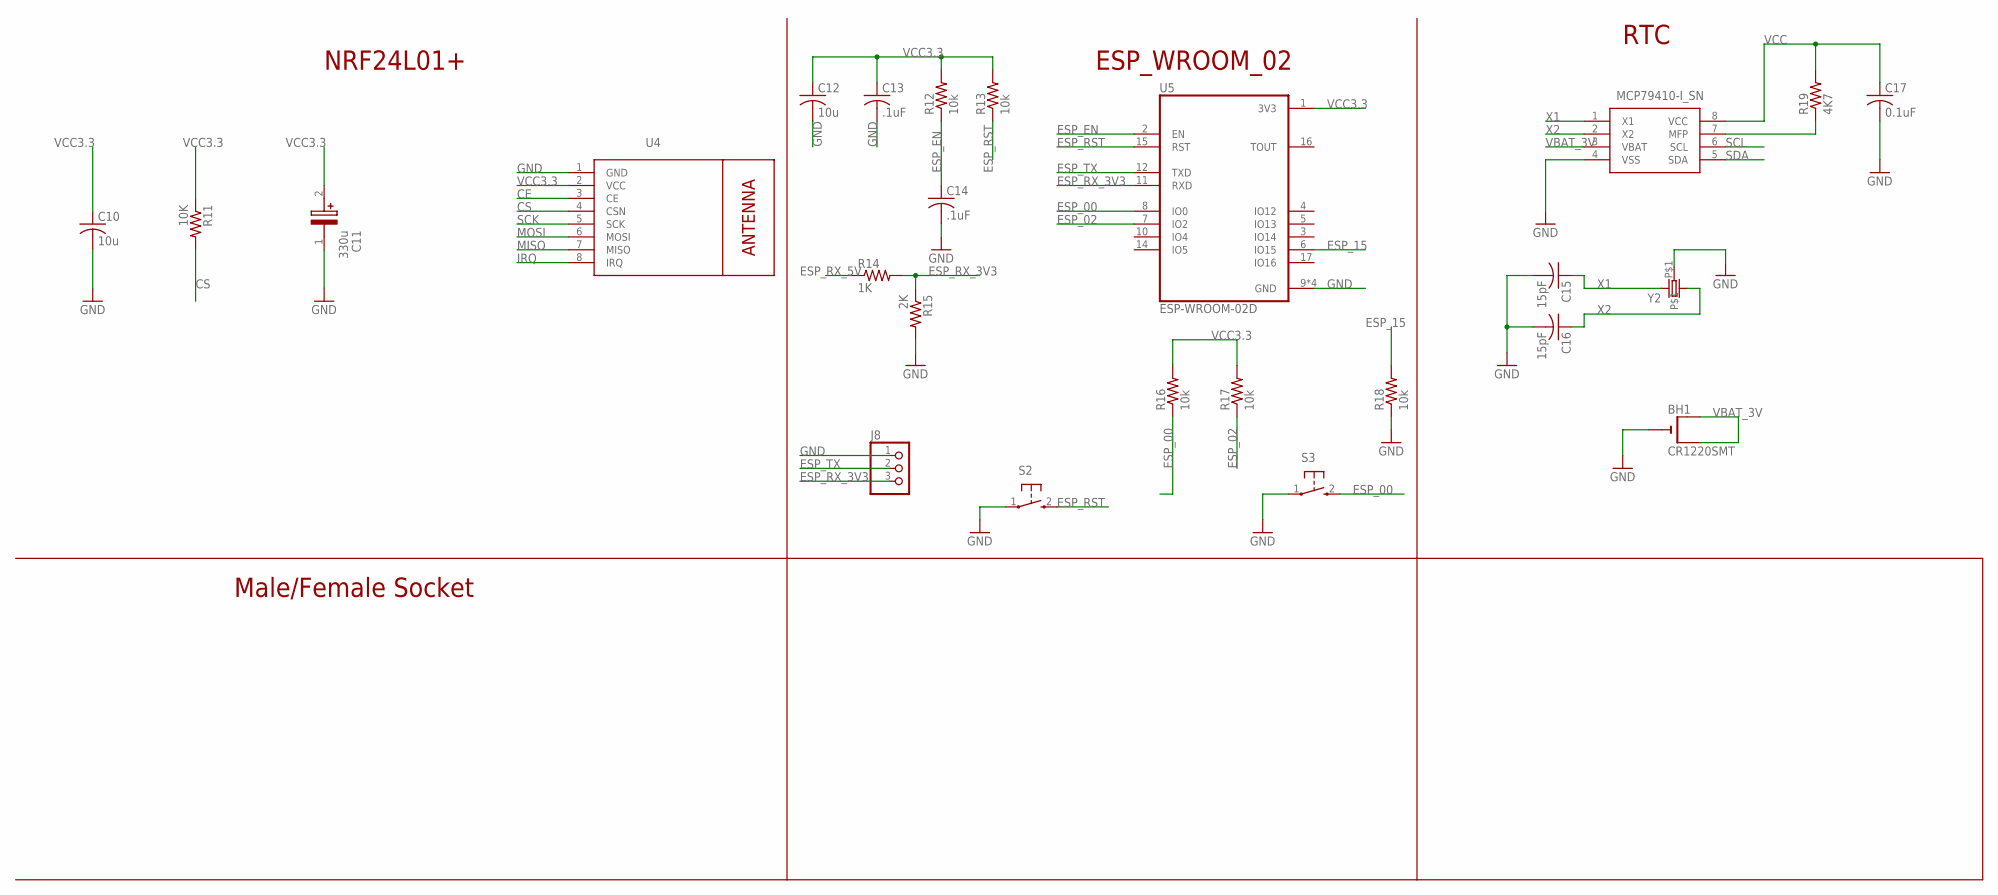
[picture p12: schematic Gateway_v1.0.sch, sheet 2]

Parts:
BH1: CR1220SMT; CR1220-SMD
C10, C12: 10u; SMD-0805
C11: 330u; SMD_LYTIC_D8
C13, C14: .1uF; SMD-0805
C15, C16: 15pF; SMD-0805
C17: 0.1uF; SMD-0805
J8: PINHD-1X3; 1X03
R11: 10K; SMD-0805
R12, R13, R16, R17, R18: 10k; SMD-0805
R14: 1K; SMD-0805
R15: 2K; SMD-0805
R19: 4K7; SMD-0805
S2, S3: SPST_TACT-KMR2; KMR2
U4: WIRELESS-NRF24L01
U5: ESP-WROOM-02D; MODULE_ESP-WROOM-02D
U6: MCP79410-I_SN; SOIC127P600X175-8N
Y2: CRYSTALTC26H; TC26H

Connections:
CE: U4.3 (CE); also elsewhere on the board
CS: R11.2, U4.4 (CSN); also elsewhere on the board
ESP_00: R16.1, S3.2 (S), U5.8 (IO0)
ESP_02: R17.1, U5.7 (IO2)
ESP_15: R18.2, U5.6 (IO15)
ESP_EN: C14.1, R12.1, U5.2 (EN)
ESP_RST: R13.1, S2.2 (S), U5.15 (RST)
ESP_RX_3V3: J8.3, R14.2, R15.1, U5.11 (RXD)
ESP_RX_5V: R14.1; also elsewhere on the board
ESP_TX: J8.2, U5.12 (TXD); also elsewhere on the board
GND: BH1.-, C10.2, C11.1, C12.2, C13.2, C14.2, C15.2, C16.2, C17.2, J8.1, R15.2, R18.1, S2.1, S3.1, U4.1 (GND), U5.9 (GND), U5.13 (GND), U5.18 (GND), U5.19 (GND), U6.4 (VSS), Y2.P$1; also elsewhere on the board
IRQ: U4.8 (IRQ); also elsewhere on the board
MISO: U4.7 (MISO); also elsewhere on the board
MOSI: U4.6 (MOSI); also elsewhere on the board
unnamed: R19.1, U6.7 (MFP)
SCK: U4.5 (SCK); also elsewhere on the board
SCL: U6.6 (SCL); also elsewhere on the board
SDA: U6.5 (SDA); also elsewhere on the board
VBAT_3V: BH1.+$1 (+), BH1.+$2 (+1), U6.3 (VBAT)
VCC: C17.1, R19.2, U6.8 (VCC); also elsewhere on the board
VCC3.3: C10.1, C11.2, C12.1, C13.1, R11.1, R12.2, R13.2, R16.2, R17.2, U4.2 (VCC), U5.1 (3V3); also elsewhere on the board
X1: C15.1, U6.1 (X1), Y2.2
X2: C16.1, U6.2 (X2), Y2.1

Notes on the sheet:
NRF24L01+
ESP_WROOM_02
Male/Female Socket
RTC

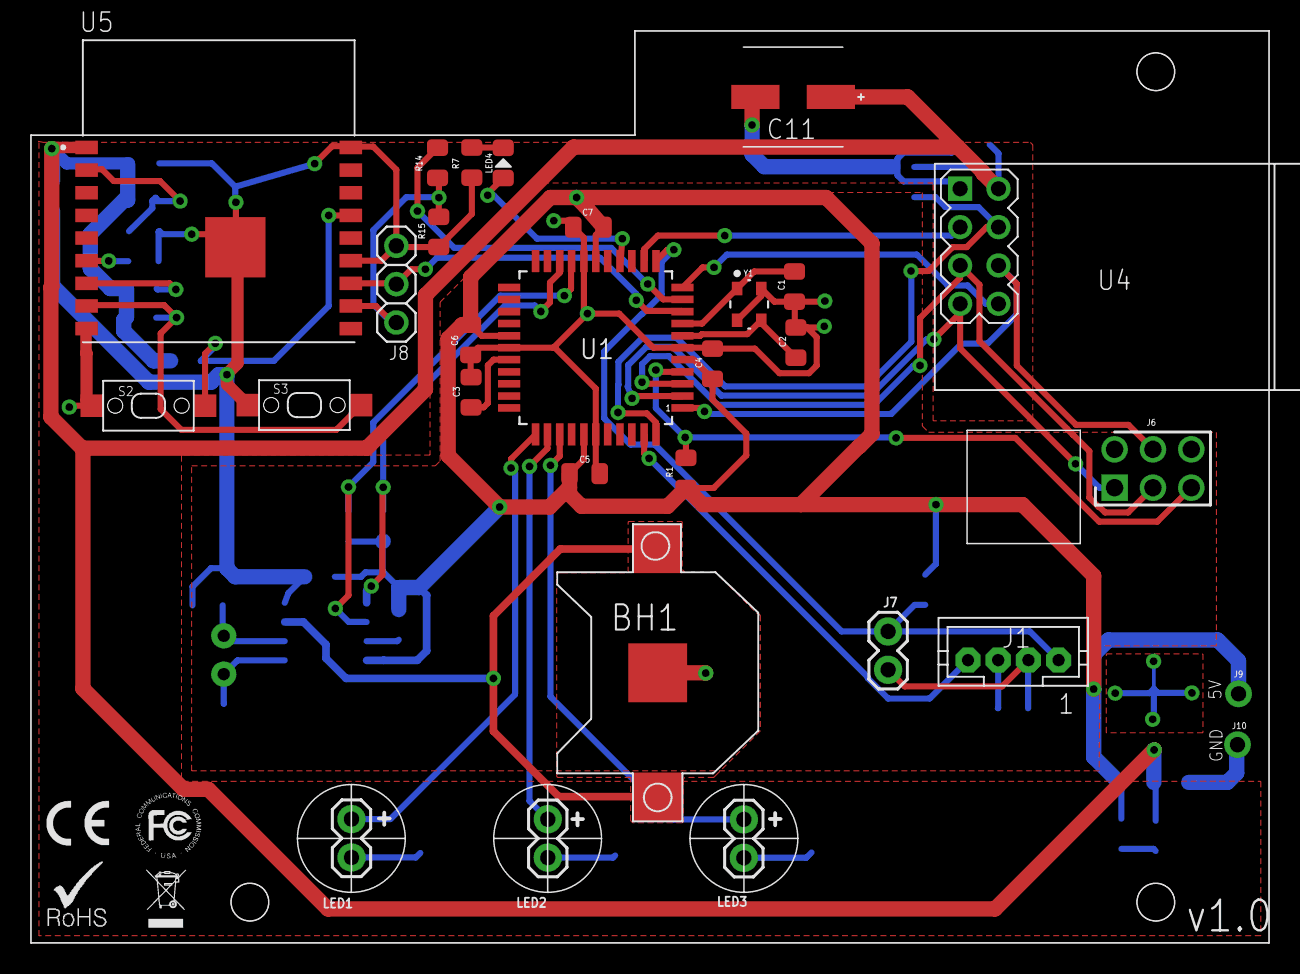
[picture p13: board Gateway_v1.0.brd from above]

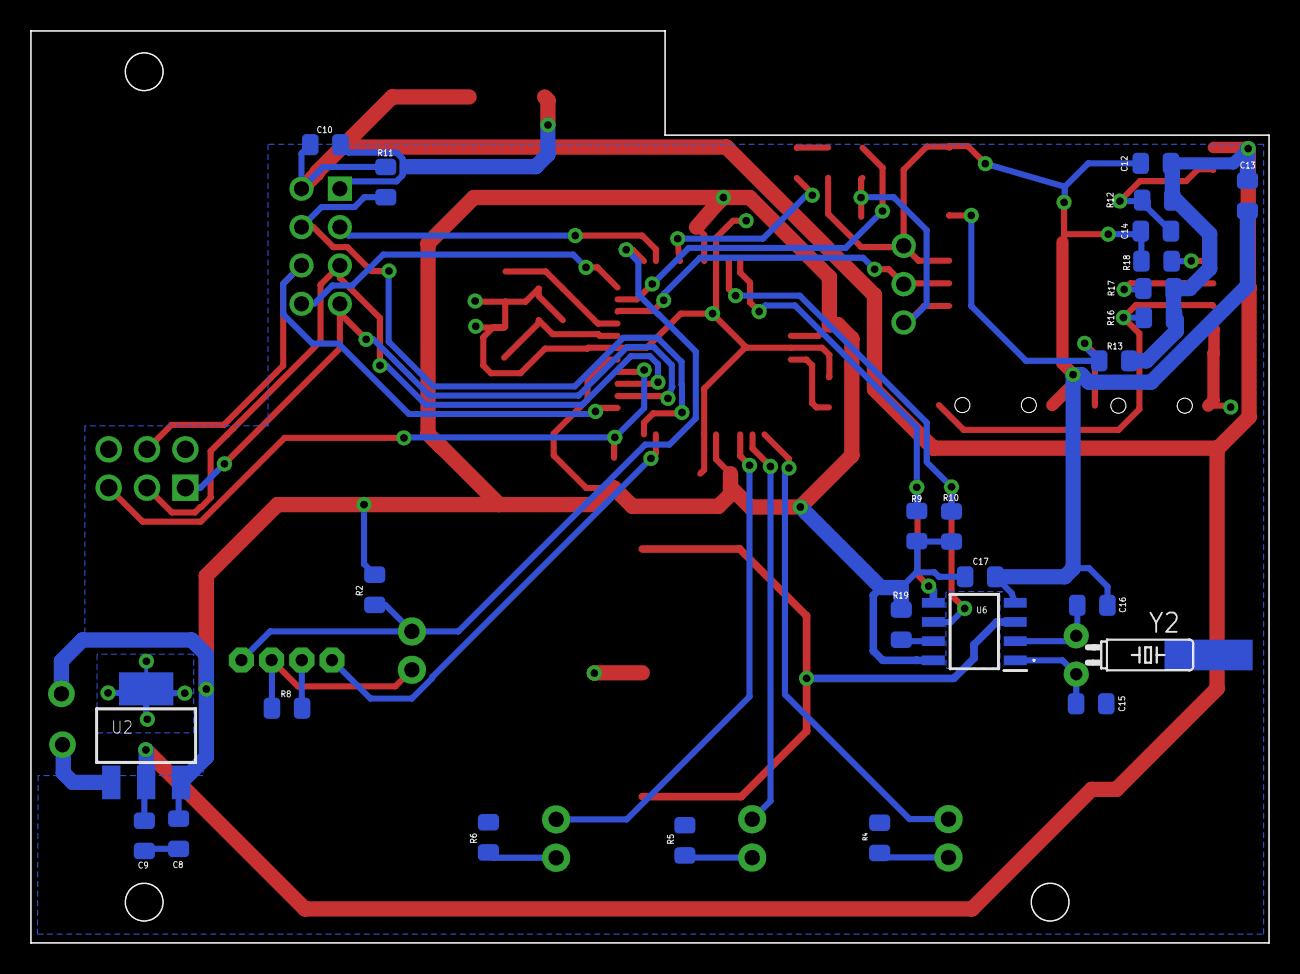
[picture p14: board Gateway_v1.0.brd from below]

Board: 2 copper layers, 82.0 x 60.4 mm, 55 parts (26 on the bottom side), 38 nets.
