nk-kotsomitis/Senseed/hardware/environment_sensor/Env_sensor_v1.0.brd

## EAGLE design hardware/environment_sensor/Env_sensor_v1.0.brd (2025-03-04)

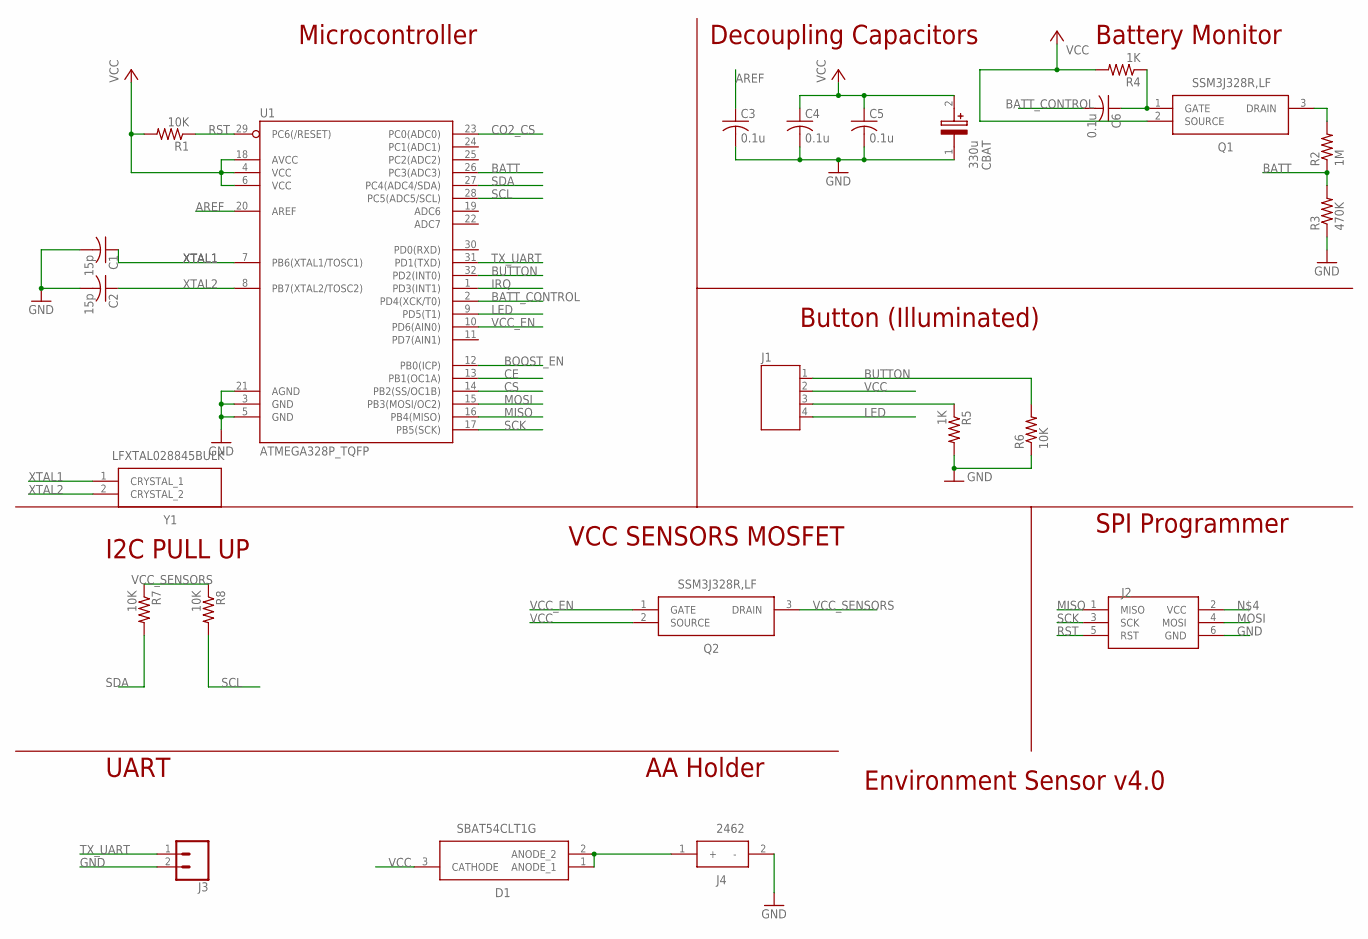
[picture p15: schematic Env_sensor_v1.0.sch, sheet 1]

Parts:
C1, C2: 15p; SMD-0805
C3, C4, C5, C6: 0.1u; SMD-0805
CBAT: 330u; SMD_LYTIC_D8
D1: SBAT54CLT1G; SOT96P237X111-3N
J1: JST-PH4
J2: ISP; AVRISP
J3: CONN_02; 1X02
J4: 2462
Q1, Q2: SSM3J328R,LF; SOTFL95P240X88-3N
R1, R6, R7, R8: 10K; SMD-0805
R2: 1M; SMD-0805
R3: 470K; SMD-0805
R4, R5: 1K; SMD-0805
U1: ATMEGA328P_TQFP; TQFP32-08
Y1: LFXTAL028845BULK

Connections:
AREF: C3.1, U1.20 (AREF)
BATT: R2.1, R3.2, U1.26 (PC3(ADC3))
BATT_CONTROL: C6.2, U1.2 (PD4(XCK/T0))
BOOST_EN: U1.12 (PB0(ICP)); also elsewhere on the board
BUTTON: J1.1, R6.2, U1.32 (PD2(INT0))
CE: U1.13 (PB1(OC1A)); also elsewhere on the board
CO2_CS: U1.23 (PC0(ADC0)); also elsewhere on the board
CS: U1.14 (PB2(SS/OC1B)); also elsewhere on the board
GND: C1.2, C2.2, C3.2, C4.2, C5.2, CBAT.1, J2.6 (GND), J3.2, J4.2 (-), R3.1, R5.2, R6.1, U1.3 (GND), U1.5 (GND), U1.21 (AGND); also elsewhere on the board
IRQ: U1.1 (PD3(INT1)); also elsewhere on the board
LED: J1.4, U1.9 (PD5(T1))
MISO: J2.1 (MISO), U1.16 (PB4(MISO)); also elsewhere on the board
MOSI: J2.4 (MOSI), U1.15 (PB3(MOSI/OC2)); also elsewhere on the board
unnamed: Q1.3 (DRAIN), R2.2
unnamed: D1.1 (ANODE_1), D1.2 (ANODE_2), J4.1 (+)
unnamed: J1.3, R5.1
unnamed: C6.1, Q1.1 (GATE), R4.1
RST: J2.5 (RST), R1.1, U1.29 (PC6(/RESET))
SCK: J2.3 (SCK), U1.17 (PB5(SCK)); also elsewhere on the board
SCL: R8.2, U1.28 (PC5(ADC5/SCL)); also elsewhere on the board
SDA: R7.2, U1.27 (PC4(ADC4/SDA)); also elsewhere on the board
TX_UART: J3.1, U1.31 (PD1(TXD))
VCC: C4.1, C5.1, CBAT.2, D1.3 (CATHODE), J1.2, Q1.2 (SOURCE), Q2.2 (SOURCE), R1.2, R4.2, U1.4 (VCC), U1.6 (VCC), U1.18 (AVCC); also elsewhere on the board
VCC_EN: Q2.1 (GATE), U1.10 (PD6(AIN0))
VCC_SENSORS: Q2.3 (DRAIN), R7.1, R8.1; also elsewhere on the board
XTAL1: C1.1, U1.7 (PB6(XTAL1/TOSC1)), Y1.1 (CRYSTAL_1)
XTAL2: C2.1, U1.8 (PB7(XTAL2/TOSC2)), Y1.2 (CRYSTAL_2)

Notes on the sheet:
Environment Sensor v4.0
Decoupling Capacitors
Battery Monitor
SPI Programmer
Microcontroller
UART
AA Holder
Button (Illuminated)
I2C PULL UP
VCC SENSORS MOSFET

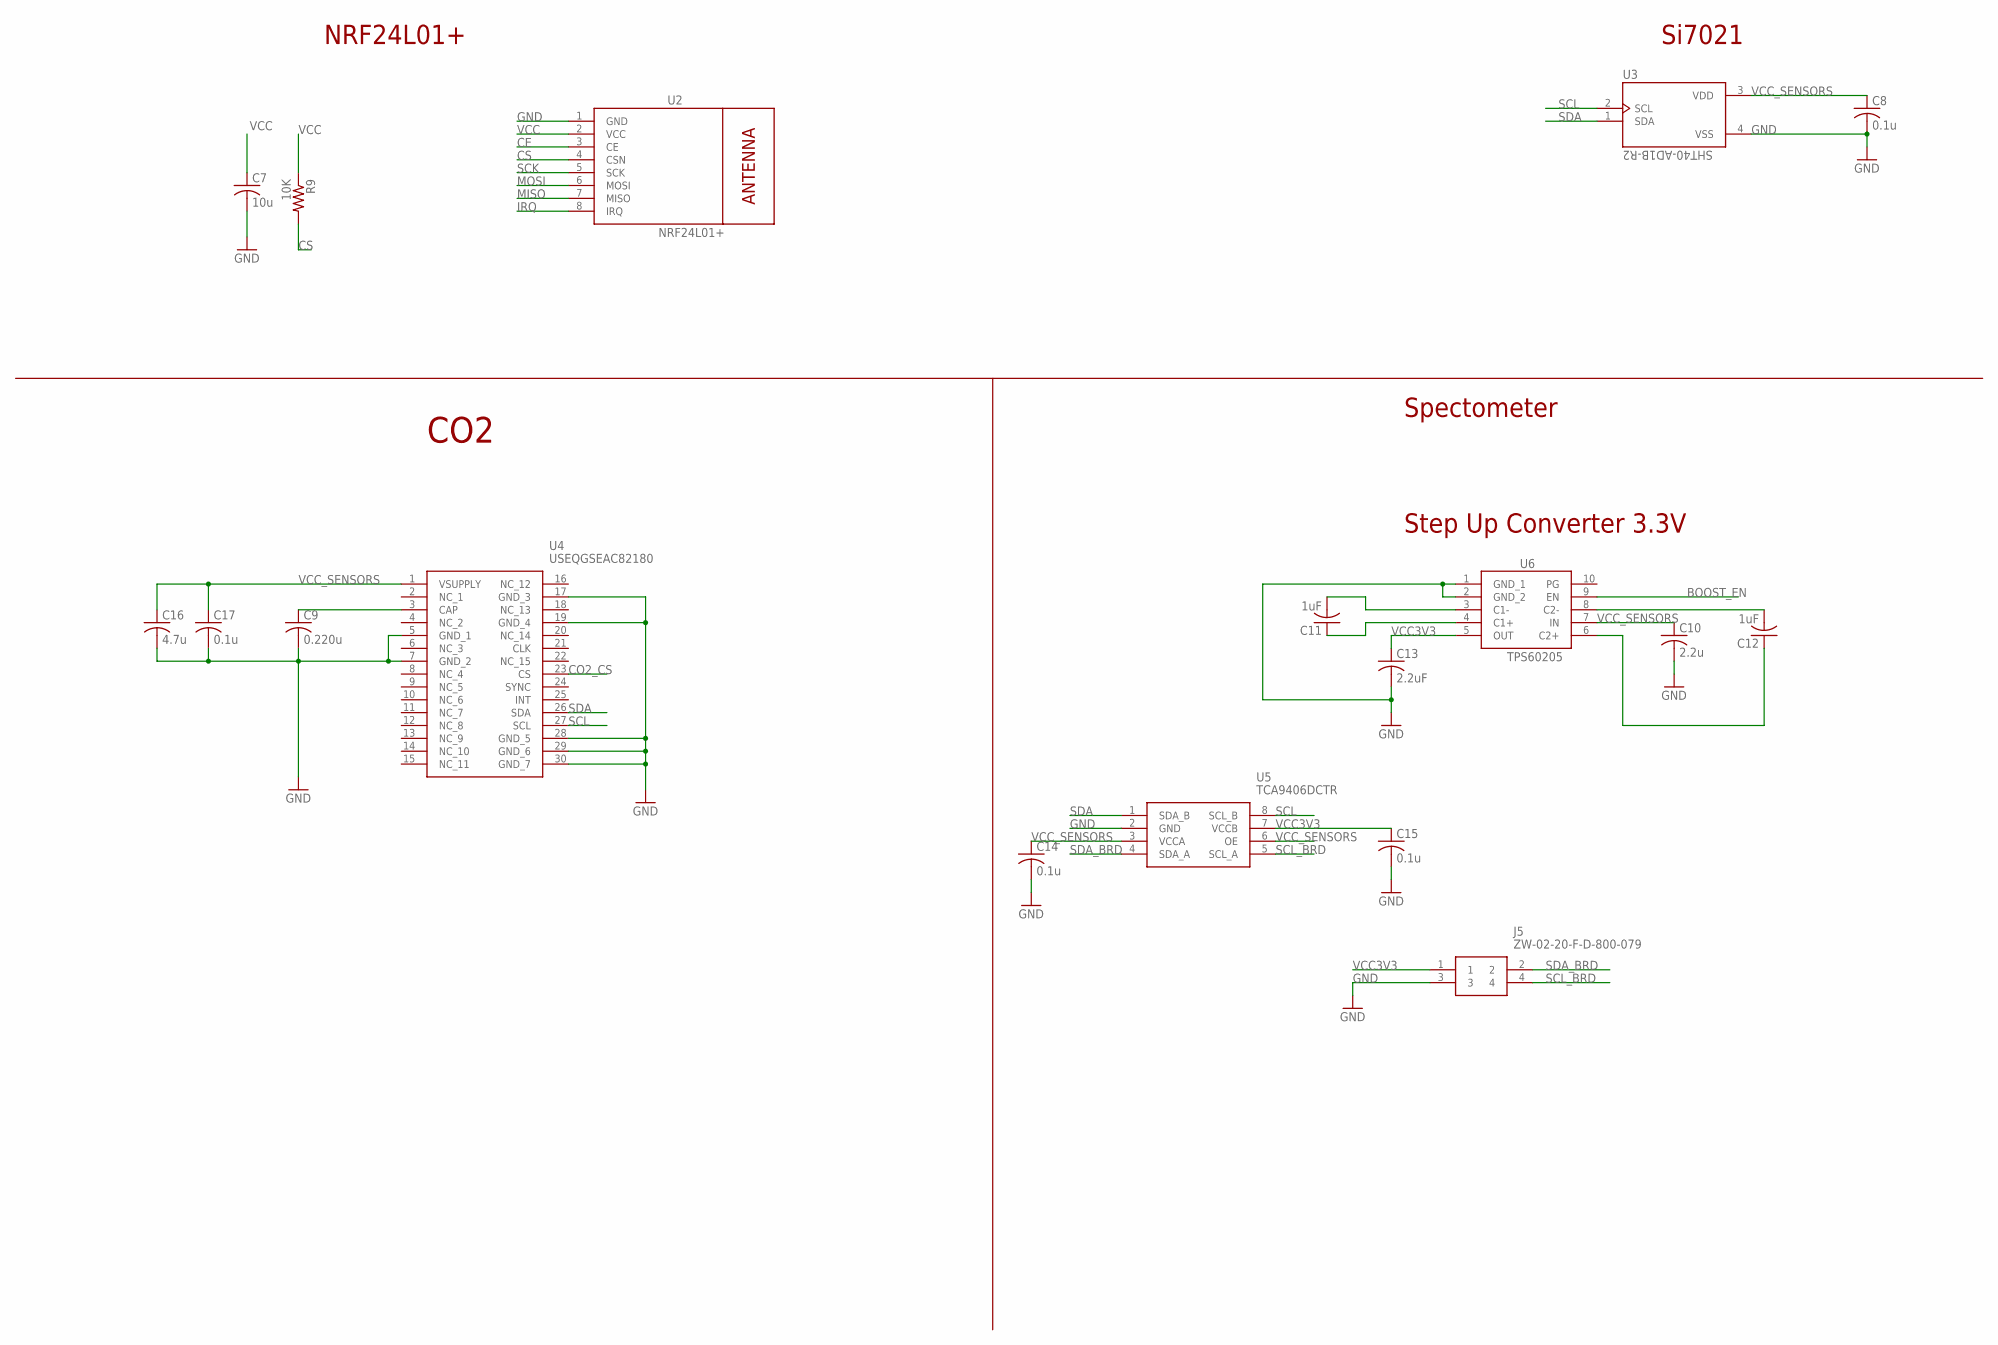
[picture p16: schematic Env_sensor_v1.0.sch, sheet 2]

Parts:
C7: 10u; SMD-0805
C8, C14, C15, C17: 0.1u; SMD-0805
C9: 0.220u; SMD-0805
C10: 2.2u; SMD-0805
C11, C12: 1uF; SMD-0805
C13: 2.2uF; SMD-0805
C16: 4.7u; SMD-0805
J5: ZW-02-20-F-D-800-079; HDRV4W64P254_2X2_508X508X2669P
R9: 10K; SMD-0805
U2: NRF24L01+; WIRELESS-NRF24L01
U3: SHT40-AD1B-R2; XDCR_SHT40-AD1B-R2
U4: USEQGSEAC82180
U5: TCA9406DCTR; SOP65P400X130-8N
U6: TPS60205; SOP50P488X107-10N

Connections:
BOOST_EN: U6.9 (EN); also elsewhere on the board
CE: U2.3 (CE); also elsewhere on the board
CO2_CS: U4.23 (CS); also elsewhere on the board
CS: R9.2, U2.4 (CSN); also elsewhere on the board
GND: C7.2, C8.2, C9.2, C10.2, C13.2, C14.2, C15.2, C16.2, C17.2, J5.3, U2.1 (GND), U3.4 (VSS), U4.5 (GND_1), U4.7 (GND_2), U4.17 (GND_3), U4.19 (GND_4), U4.28 (GND_5), U4.29 (GND_6), U4.30 (GND_7), U5.2 (GND), U6.1 (GND_1), U6.2 (GND_2); also elsewhere on the board
IRQ: U2.8 (IRQ); also elsewhere on the board
MISO: U2.7 (MISO); also elsewhere on the board
MOSI: U2.6 (MOSI); also elsewhere on the board
unnamed: C9.1, U4.3 (CAP)
unnamed: C11.1, U6.4 (C1+)
unnamed: C11.2, U6.3 (C1-)
unnamed: C12.1, U6.6 (C2+)
unnamed: C12.2, U6.8 (C2-)
SCK: U2.5 (SCK); also elsewhere on the board
SCL: U3.2 (SCL), U4.27 (SCL), U5.8 (SCL_B); also elsewhere on the board
SCL_BRD: J5.4, U5.5 (SCL_A)
SDA: U3.1 (SDA), U4.26 (SDA), U5.1 (SDA_B); also elsewhere on the board
SDA_BRD: J5.2, U5.4 (SDA_A)
VCC: C7.1, R9.1, U2.2 (VCC); also elsewhere on the board
VCC3V3: C13.1, C15.1, J5.1, U5.7 (VCCB), U6.5 (OUT)
VCC_SENSORS: C8.1, C10.1, C14.1, C16.1, C17.1, U3.3 (VDD), U4.1 (VSUPPLY), U5.3 (VCCA), U5.6 (OE), U6.7 (IN); also elsewhere on the board

Notes on the sheet:
NRF24L01+
Si7021
Spectometer
CO2
Step Up Converter 3.3V

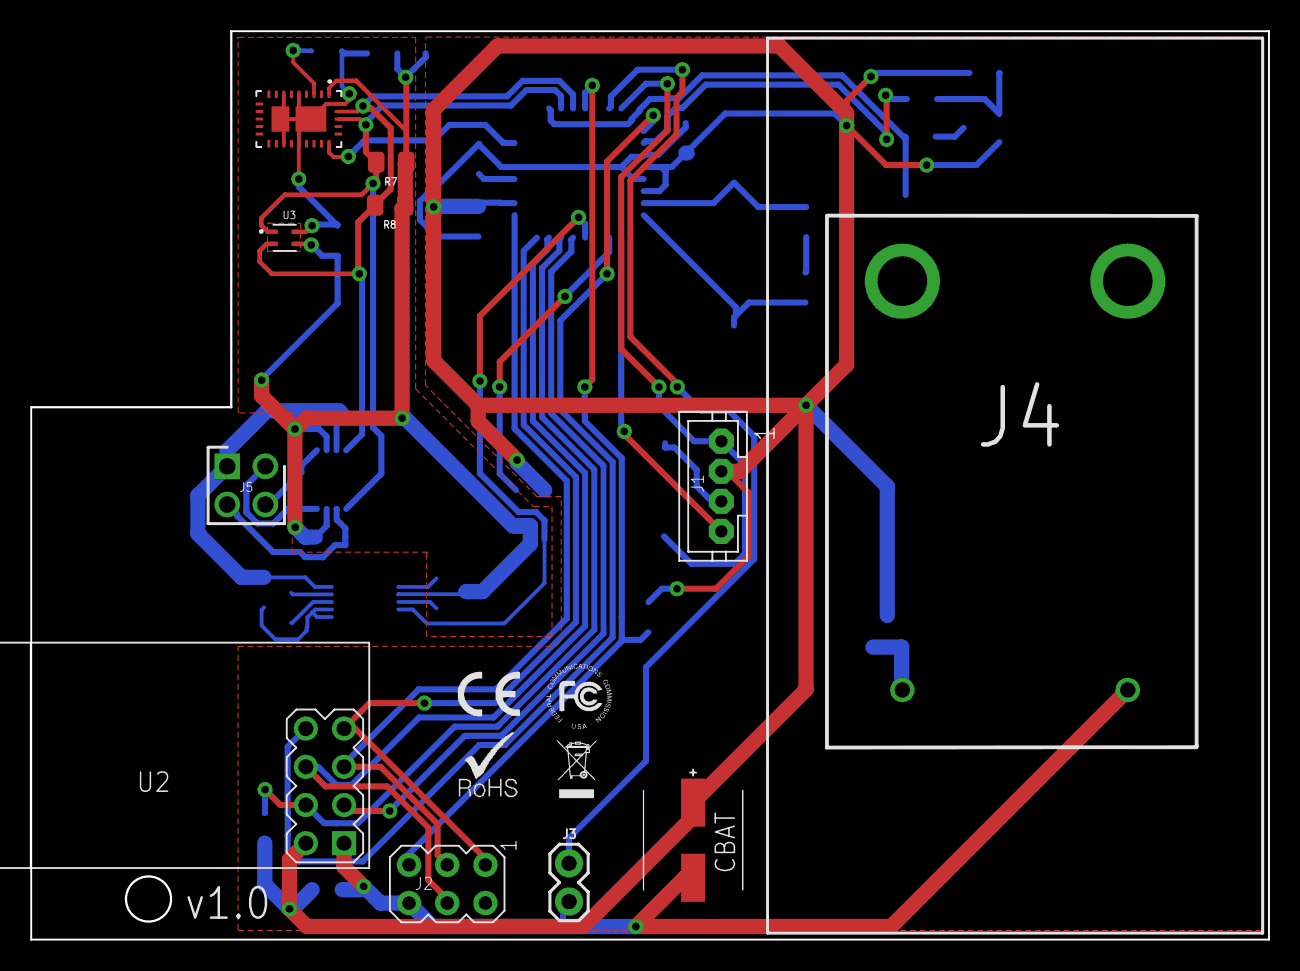
[picture p17: board Env_sensor_v1.0.brd from above]

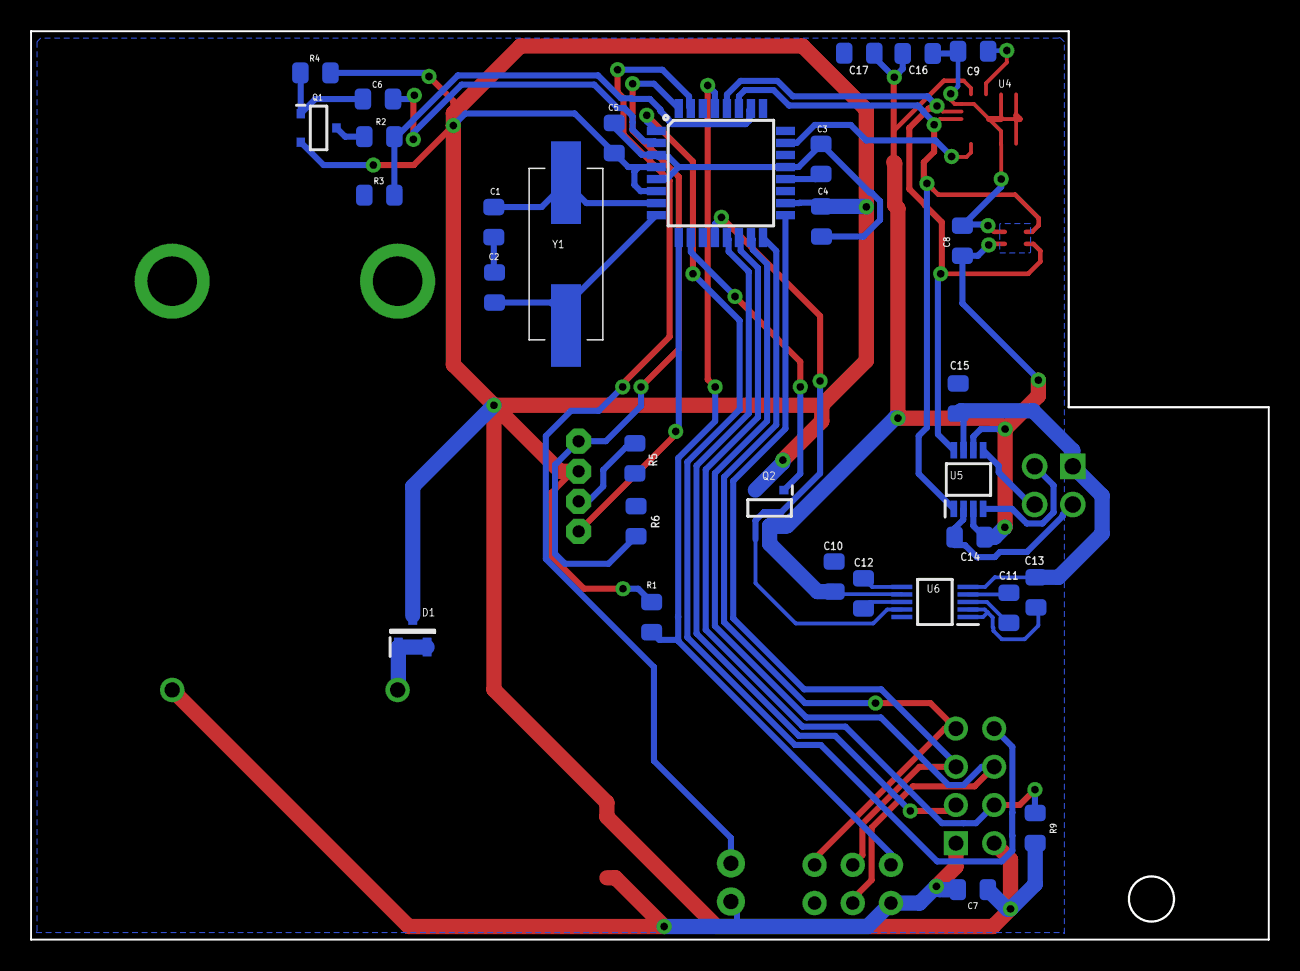
[picture p18: board Env_sensor_v1.0.brd from below]

Board: 2 copper layers, 82.3 x 60.4 mm, 42 parts (31 on the bottom side), 35 nets.
